fermentedfly/tankia_2013/README.md

# TANKIA 2013
There Are [still] No Kangaroos In Austria

This repository contains hard & software for TANKIA 2013 developed after end of season 2013
