fermentedfly/tankia_2013/layouts/steering_wheel_V3.0.brd

## EAGLE design layouts/steering_wheel_V3.0.brd (2016-11-24, an earlier design)

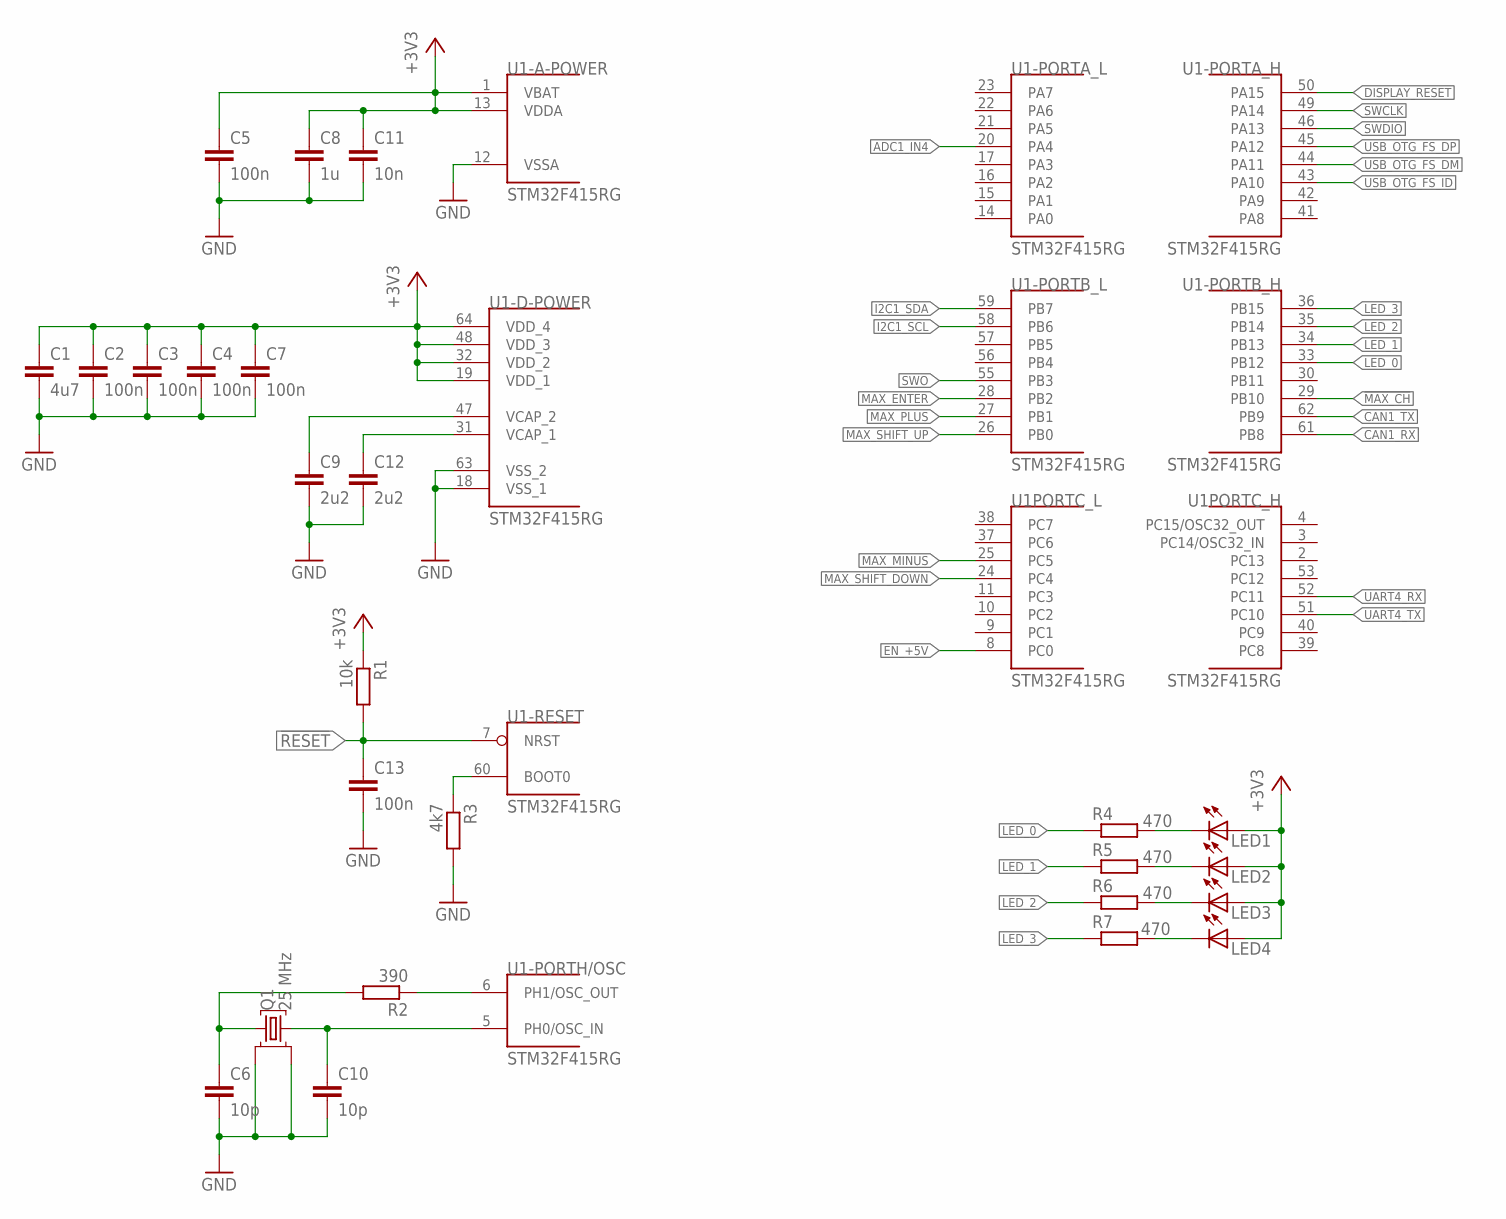
[picture p1: schematic steering_wheel_V3.0.sch, sheet 1]

Parts:
C1: 4u7; C0603
C2, C3, C4, C5, C7, C13: 100n; C0603
C6, C10: 10p; C0603
C8: 1u; C0603
C9, C12: 2u2; C0603
C11: 10n; C0603
LED1, LED2, LED3, LED4: LEDCHIPLED_0603; CHIPLED_0603
Q1: 25 MHz; 3.2X2.5MM-SMD
R1: 10k; R0603
R2: 390; R0603
R3: 4k7; R0603
R4, R5, R6, R7: 470; R0603
U1: STM32F415RG; LQFP64

Connections:
!MAX_CH: U1.29 (PB10); also elsewhere on the board
!RESET: C13.1, R1.2, U1.7 (NRST); also elsewhere on the board
+3V3: C1.1, C2.1, C3.1, C4.1, C5.1, C7.1, C8.1, C11.1, LED1.A, LED2.A, LED3.A, LED4.A, R1.1, U1.1 (VBAT), U1.13 (VDDA), U1.19 (VDD_1), U1.32 (VDD_2), U1.48 (VDD_3), U1.64 (VDD_4); also elsewhere on the board
ADC1_IN4: U1.20 (PA4); also elsewhere on the board
CAN1_RX: U1.61 (PB8); also elsewhere on the board
CAN1_TX: U1.62 (PB9); also elsewhere on the board
DISPLAY_RESET: U1.50 (PA15); also elsewhere on the board
EN_+5V: U1.8 (PC0); also elsewhere on the board
GND: C1.2, C2.2, C3.2, C4.2, C5.2, C6.2, C7.2, C8.2, C9.2, C10.2, C11.2, C12.2, C13.2, Q1.2 (GND1), Q1.4 (GND2), R3.2, U1.12 (VSSA), U1.18 (VSS_1), U1.63 (VSS_2); also elsewhere on the board
I2C1_SCL: U1.58 (PB6); also elsewhere on the board
I2C1_SDA: U1.59 (PB7); also elsewhere on the board
LED_0: R4.1, U1.33 (PB12)
LED_1: R5.1, U1.34 (PB13)
LED_2: R6.1, U1.35 (PB14)
LED_3: R7.1, U1.36 (PB15)
MAX_ENTER: U1.28 (PB2); also elsewhere on the board
MAX_MINUS: U1.25 (PC5); also elsewhere on the board
MAX_PLUS: U1.27 (PB1); also elsewhere on the board
MAX_SHIFT_DOWN: U1.24 (PC4); also elsewhere on the board
MAX_SHIFT_UP: U1.26 (PB0); also elsewhere on the board
unnamed: C9.1, U1.47 (VCAP_2)
unnamed: C12.1, U1.31 (VCAP_1)
unnamed: R2.1, U1.6 (PH1/OSC_OUT)
unnamed: C10.1, Q1.3 (Q2), U1.5 (PH0/OSC_IN)
unnamed: LED4.C, R7.2
unnamed: R3.1, U1.60 (BOOT0)
unnamed: LED2.C, R5.2
unnamed: LED3.C, R6.2
unnamed: C6.1, Q1.1 (Q1), R2.2
unnamed: LED1.C, R4.2
SWCLK: U1.49 (PA14); also elsewhere on the board
SWDIO: U1.46 (PA13); also elsewhere on the board
SWO: U1.55 (PB3); also elsewhere on the board
UART4_RX: U1.52 (PC11); also elsewhere on the board
UART4_TX: U1.51 (PC10); also elsewhere on the board
USB_OTG_FS_DM: U1.44 (PA11); also elsewhere on the board
USB_OTG_FS_DP: U1.45 (PA12); also elsewhere on the board
USB_OTG_FS_ID: U1.43 (PA10); also elsewhere on the board

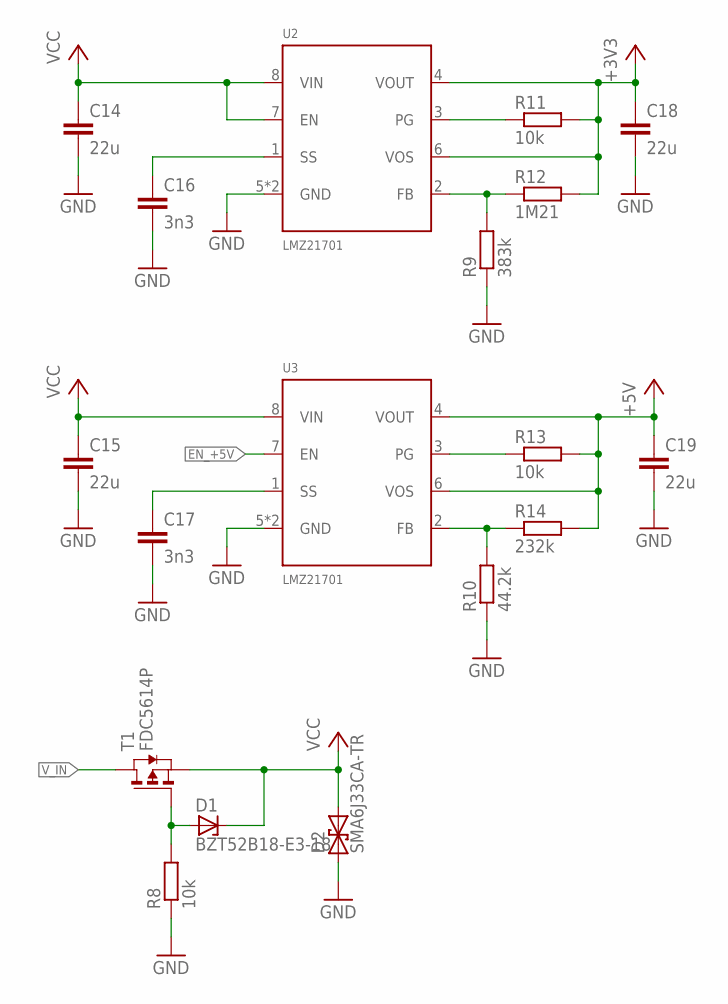
[picture p2: schematic steering_wheel_V3.0.sch, sheet 2]

Parts:
C14, C15, C18, C19: 22u; C1210
C16, C17: 3n3; C0603
D1: BZT52B18-E3-18; SOD123F
D2: SMA6J33CA-TR; DO214AC
R8, R11, R13: 10k; R0603
R9: 383k; R0603
R10: 44.2k; R0603
R12: 1M21; R0603
R14: 232k; R0603
T1: FDC5614P; SSOT6
U2, U3: LMZ21701; SIL0008E

Connections:
+3V3: C18.1, R11.2, R12.2, U2.4 (VOUT), U2.6 (VOS); also elsewhere on the board
+5V: C19.1, R13.2, R14.2, U3.4 (VOUT), U3.6 (VOS); also elsewhere on the board
EN_+5V: U3.7 (EN); also elsewhere on the board
GND: C14.2, C15.2, C16.2, C17.2, C18.2, C19.2, D2.A (1), R8.1, R9.1, R10.1, U2.5 (GND), U2.PAD (GND), U3.5 (GND), U3.PAD (GND); also elsewhere on the board
unnamed: D1.A, R8.2, T1.3 (G)
unnamed: C16.1, U2.1 (SS)
unnamed: C17.1, U3.1 (SS)
unnamed: R13.1, U3.3 (PG)
unnamed: R11.1, U2.3 (PG)
unnamed: R9.2, R12.1, U2.2 (FB)
unnamed: R10.2, R14.1, U3.2 (FB)
VCC: C14.1, C15.1, D1.C, D2.C (2), T1.4 (S), U2.7 (EN), U2.8 (VIN), U3.8 (VIN)
V_IN: T1.1 (D), T1.2 (D), T1.5 (D), T1.6 (D); also elsewhere on the board

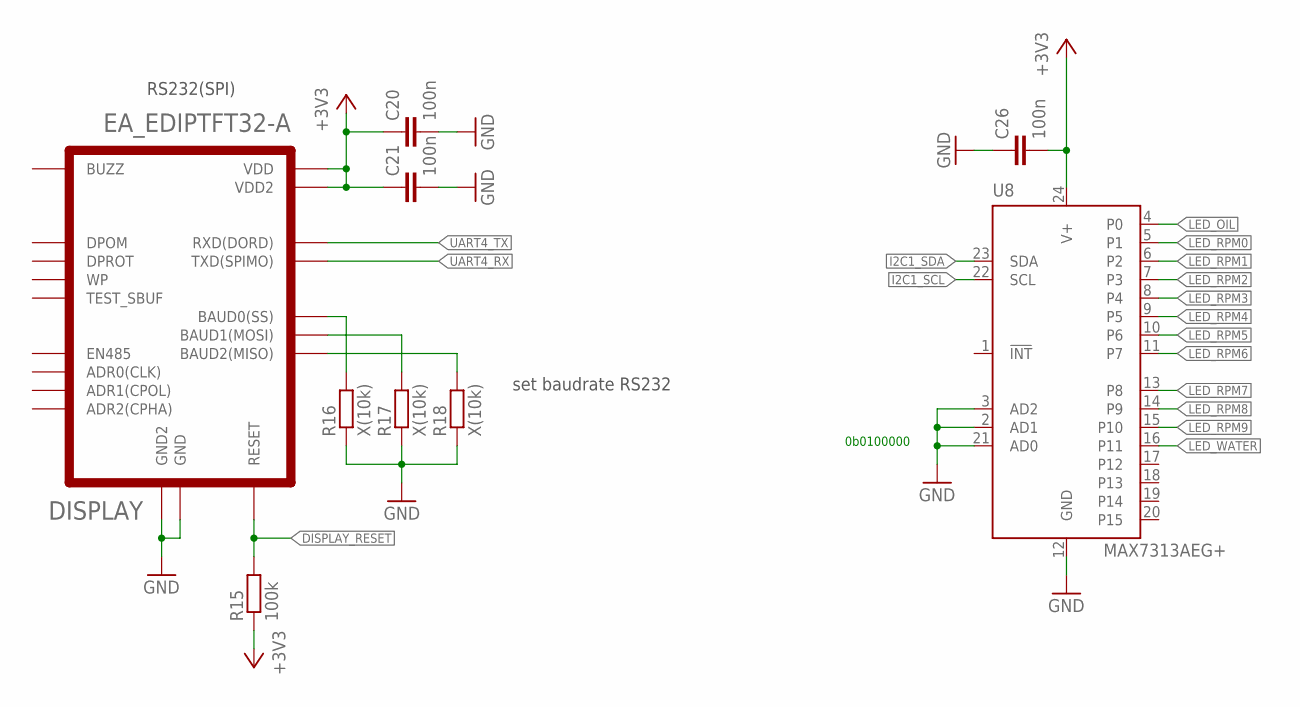
[picture p3: schematic steering_wheel_V3.0.sch, sheet 3]

Parts:
C20, C21, C26: 100n; C0603
DISPLAY: EA_EDIPTFT32-A; EDIPTFT32-A
R15: 100k; R0603
R16, R17, R18: X(10k); R0603
U8: MAX7313AEG+; QSOP-24

Connections:
+3V3: C20.1, C21.1, C26.2, DISPLAY.P$2 (VDD), DISPLAY.P$22 (VDD2), R15.1, U8.24 (V+); also elsewhere on the board
DISPLAY_RESET: DISPLAY.P$5 (RESET), R15.2; also elsewhere on the board
GND: C20.2, C21.2, C26.1, DISPLAY.P$1 (GND), DISPLAY.P$21 (GND2), R16.1, R17.1, R18.1, U8.2 (AD1), U8.3 (AD2), U8.12 (GND), U8.21 (AD0); also elsewhere on the board
I2C1_SCL: U8.22 (SCL); also elsewhere on the board
I2C1_SDA: U8.23 (SDA); also elsewhere on the board
LED_OIL: U8.4 (P0); also elsewhere on the board
LED_RPM0: U8.5 (P1); also elsewhere on the board
LED_RPM1: U8.6 (P2); also elsewhere on the board
LED_RPM2: U8.7 (P3); also elsewhere on the board
LED_RPM3: U8.8 (P4); also elsewhere on the board
LED_RPM4: U8.9 (P5); also elsewhere on the board
LED_RPM5: U8.10 (P6); also elsewhere on the board
LED_RPM6: U8.11 (P7); also elsewhere on the board
LED_RPM7: U8.13 (P8); also elsewhere on the board
LED_RPM8: U8.14 (P9); also elsewhere on the board
LED_RPM9: U8.15 (P10); also elsewhere on the board
LED_WATER: U8.16 (P11); also elsewhere on the board
unnamed: DISPLAY.P$8 (BAUD2(MISO)), R18.2
unnamed: DISPLAY.P$7 (BAUD1(MOSI)), R17.2
unnamed: DISPLAY.P$6 (BAUD0(SS)), R16.2
UART4_RX: DISPLAY.P$11 (TXD(SPIMO)); also elsewhere on the board
UART4_TX: DISPLAY.P$10 (RXD(DORD)); also elsewhere on the board

Notes on the sheet:
set baudrate RS232
0b0100000

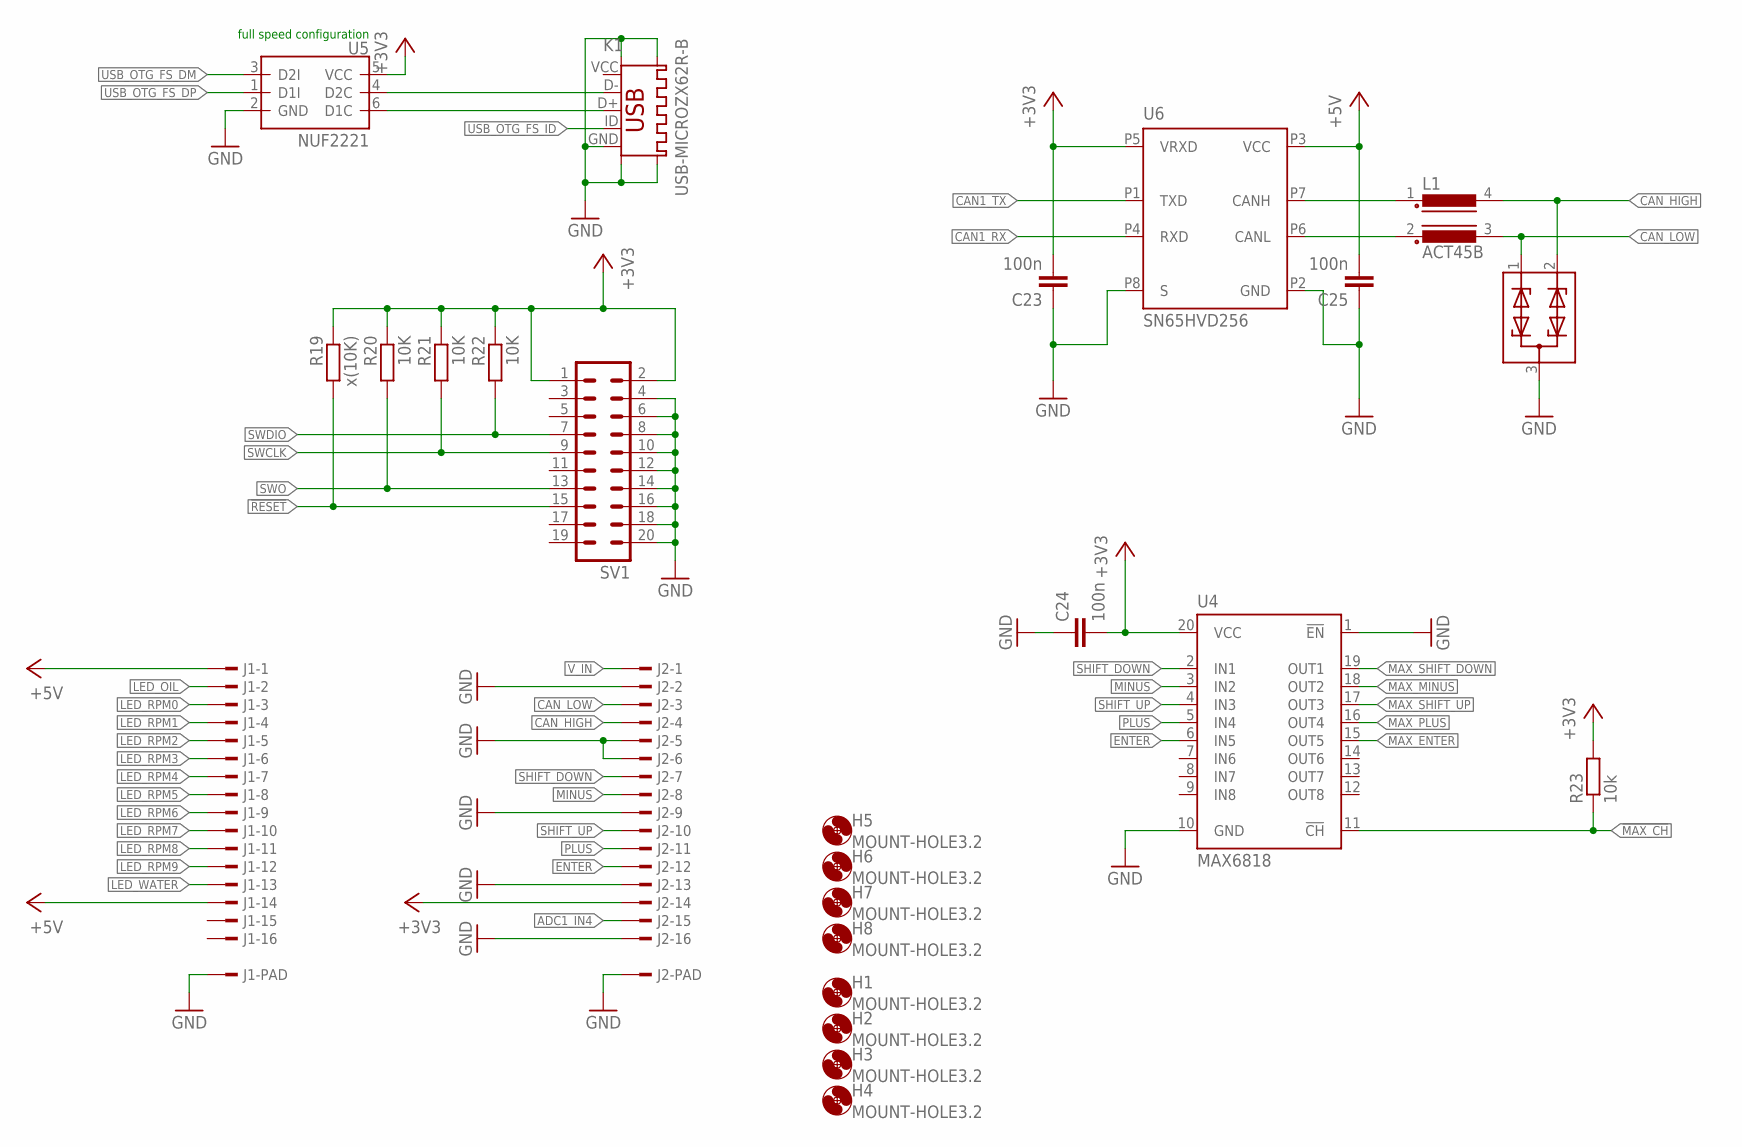
[picture p4: schematic steering_wheel_V3.0.sch, sheet 4]

Parts:
C23, C24, C25: 100n; C0603
D3: PESD1CAN-U; SOT-323
H1, H2, H3, H4, H5, H6, H7, H8: MOUNT-HOLE3.2; 3,2
J1, J2: 1-292227-6
K1: USB-MICROZX62R-B; ZX62R-B
L1: ACT45B
R19: x(10K); R0603
R20, R21, R22: 10K; R0603
R23: 10k; R0603
SV1: ML20
U4: MAX6818; SSOP-20
U5: NUF2221; SOT363
U6: SN65HVD256; SOIC8

Connections:
!MAX_CH: R23.1, U4.11 (!CH); also elsewhere on the board
!RESET: R19.2, SV1.15; also elsewhere on the board
+3V3: C23.2, C24.2, J2.14, R19.1, R20.1, R21.1, R22.1, R23.2, SV1.1, SV1.2, U4.20 (VCC), U5.5 (VCC), U6.P5 (VRXD); also elsewhere on the board
+5V: C25.2, J1.1, J1.14, U6.P3 (VCC); also elsewhere on the board
ADC1_IN4: J2.15; also elsewhere on the board
CAN1_RX: U6.P4 (RXD); also elsewhere on the board
CAN1_TX: U6.P1 (TXD); also elsewhere on the board
CAN_HIGH: D3.2, J2.4, L1.4
CAN_LOW: D3.1, J2.3, L1.3
ENTER: J2.12, U4.6 (IN5)
GND: C23.1, C24.1, C25.1, D3.3, J1.PAD1, J1.PAD2, J2.2, J2.5, J2.6, J2.9, J2.13, J2.16, J2.PAD1, J2.PAD2, K1.GND, K1.P$6 (GND3), K1.P$7 (GND4), K1.P$8 (GND1), K1.P$9 (GND2), SV1.4, SV1.6, SV1.8, SV1.10, SV1.12, SV1.14, SV1.16, SV1.18, SV1.20, U4.1 (!EN), U4.10 (GND), U5.2 (GND), U6.P2 (GND), U6.P8 (S); also elsewhere on the board
LED_OIL: J1.2; also elsewhere on the board
LED_RPM0: J1.3; also elsewhere on the board
LED_RPM1: J1.4; also elsewhere on the board
LED_RPM2: J1.5; also elsewhere on the board
LED_RPM3: J1.6; also elsewhere on the board
LED_RPM4: J1.7; also elsewhere on the board
LED_RPM5: J1.8; also elsewhere on the board
LED_RPM6: J1.9; also elsewhere on the board
LED_RPM7: J1.10; also elsewhere on the board
LED_RPM8: J1.11; also elsewhere on the board
LED_RPM9: J1.12; also elsewhere on the board
LED_WATER: J1.13; also elsewhere on the board
MAX_ENTER: U4.15 (OUT5); also elsewhere on the board
MAX_MINUS: U4.18 (OUT2); also elsewhere on the board
MAX_PLUS: U4.16 (OUT4); also elsewhere on the board
MAX_SHIFT_DOWN: U4.19 (OUT1); also elsewhere on the board
MAX_SHIFT_UP: U4.17 (OUT3); also elsewhere on the board
MINUS: J2.8, U4.3 (IN2)
unnamed: L1.1, U6.P7 (CANH)
unnamed: L1.2, U6.P6 (CANL)
PLUS: J2.11, U4.5 (IN4)
SHIFT_DOWN: J2.7, U4.2 (IN1)
SHIFT_UP: J2.10, U4.4 (IN3)
SWCLK: R21.2, SV1.9; also elsewhere on the board
SWDIO: R22.2, SV1.7; also elsewhere on the board
SWO: R20.2, SV1.13; also elsewhere on the board
USB_DM: K1.D-, U5.4 (D2C)
USB_DP: K1.D+, U5.6 (D1C)
USB_OTG_FS_DM: U5.3 (D2I); also elsewhere on the board
USB_OTG_FS_DP: U5.1 (D1I); also elsewhere on the board
USB_OTG_FS_ID: K1.ID; also elsewhere on the board
V_IN: J2.1; also elsewhere on the board

Notes on the sheet:
full speed configuration

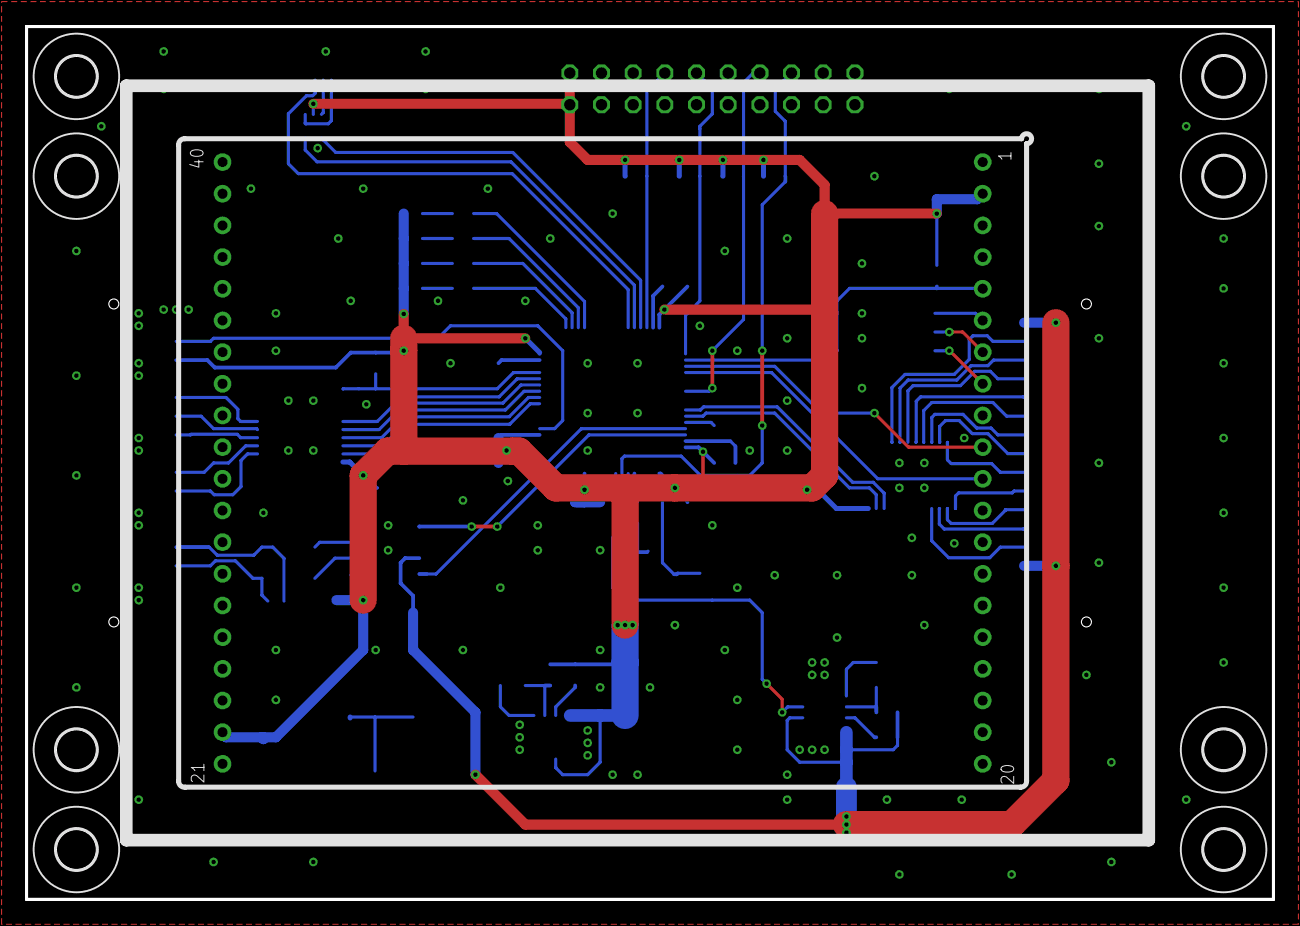
[picture p5: board steering_wheel_V3.0.brd from above]

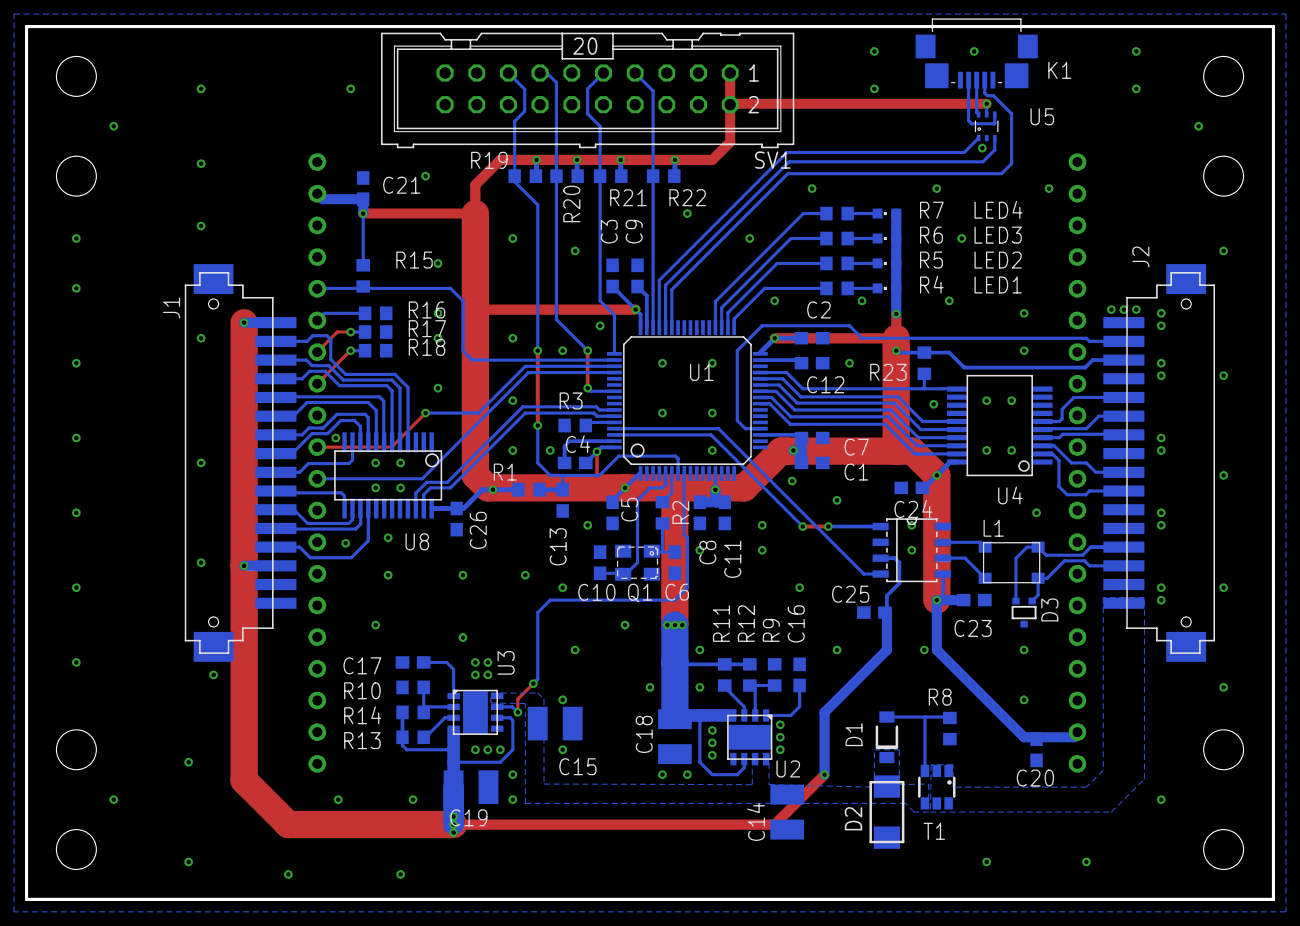
[picture p6: board steering_wheel_V3.0.brd from below]

Board: 2 copper layers, 100.0 x 70.0 mm, 78 parts (69 on the bottom side), 74 nets.
