fermentedfly/tankia_2013/layouts/led_mask.brd

## EAGLE design layouts/led_mask.brd (2016-11-24)

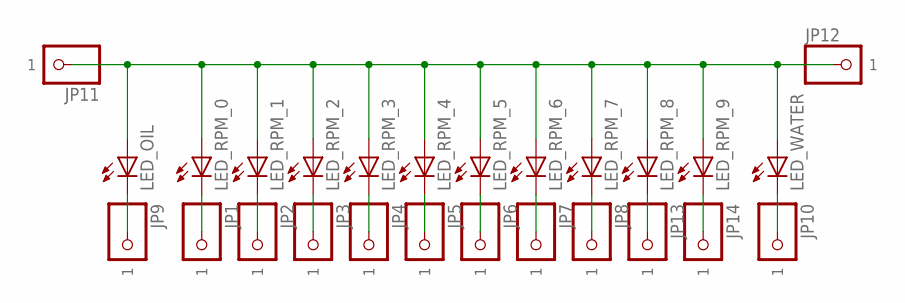
[picture p7: schematic led_mask.sch]

Parts:
JP1, JP2, JP3, JP4, JP5, JP6, JP7, JP8, JP9, JP10, JP11, JP12, JP13, JP14: PINHD-1X11.5X2.5MM_SMD; 1XSMD1.5X2.5MM
LED_OIL: LED3MM
LED_RPM_0, LED_RPM_1, LED_RPM_2, LED_RPM_3, LED_RPM_4, LED_RPM_5, LED_RPM_6, LED_RPM_7, LED_RPM_8, LED_RPM_9: LED3MM
LED_WATER: LED3MM

Connections:
unnamed: JP11.P$1, JP12.P$1, LED_OIL.A, LED_RPM_0.A, LED_RPM_1.A, LED_RPM_2.A, LED_RPM_3.A, LED_RPM_4.A, LED_RPM_5.A, LED_RPM_6.A, LED_RPM_7.A, LED_RPM_8.A, LED_RPM_9.A, LED_WATER.A
unnamed: JP3.P$1, LED_RPM_2.K (C)
unnamed: JP1.P$1, LED_RPM_0.K (C)
unnamed: JP2.P$1, LED_RPM_1.K (C)
unnamed: JP4.P$1, LED_RPM_3.K (C)
unnamed: JP5.P$1, LED_RPM_4.K (C)
unnamed: JP6.P$1, LED_RPM_5.K (C)
unnamed: JP7.P$1, LED_RPM_6.K (C)
unnamed: JP8.P$1, LED_RPM_7.K (C)
unnamed: JP9.P$1, LED_OIL.K (C)
unnamed: JP10.P$1, LED_WATER.K (C)
unnamed: JP13.P$1, LED_RPM_8.K (C)
unnamed: JP14.P$1, LED_RPM_9.K (C)

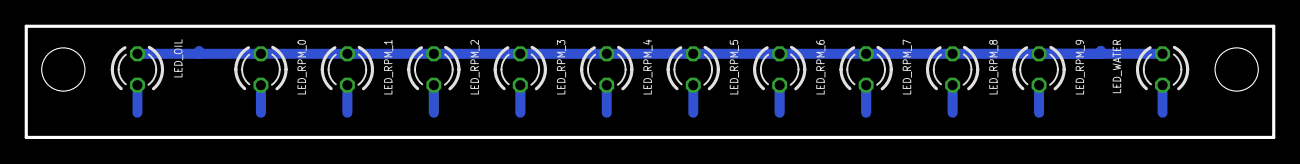
[picture p8: board led_mask.brd from above]

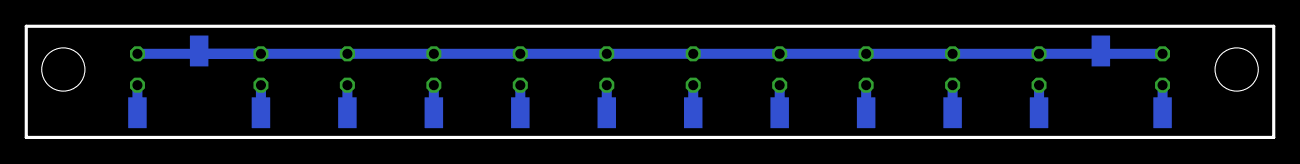
[picture p9: board led_mask.brd from below]

Board: 2 copper layers, 101.0 x 9.0 mm, 26 parts (14 on the bottom side), 13 nets.
