fermentedfly/tankia_2013/layouts/steering_wheel_V2.brd

## EAGLE design layouts/steering_wheel_V2.brd (2016-11-24, an earlier design)

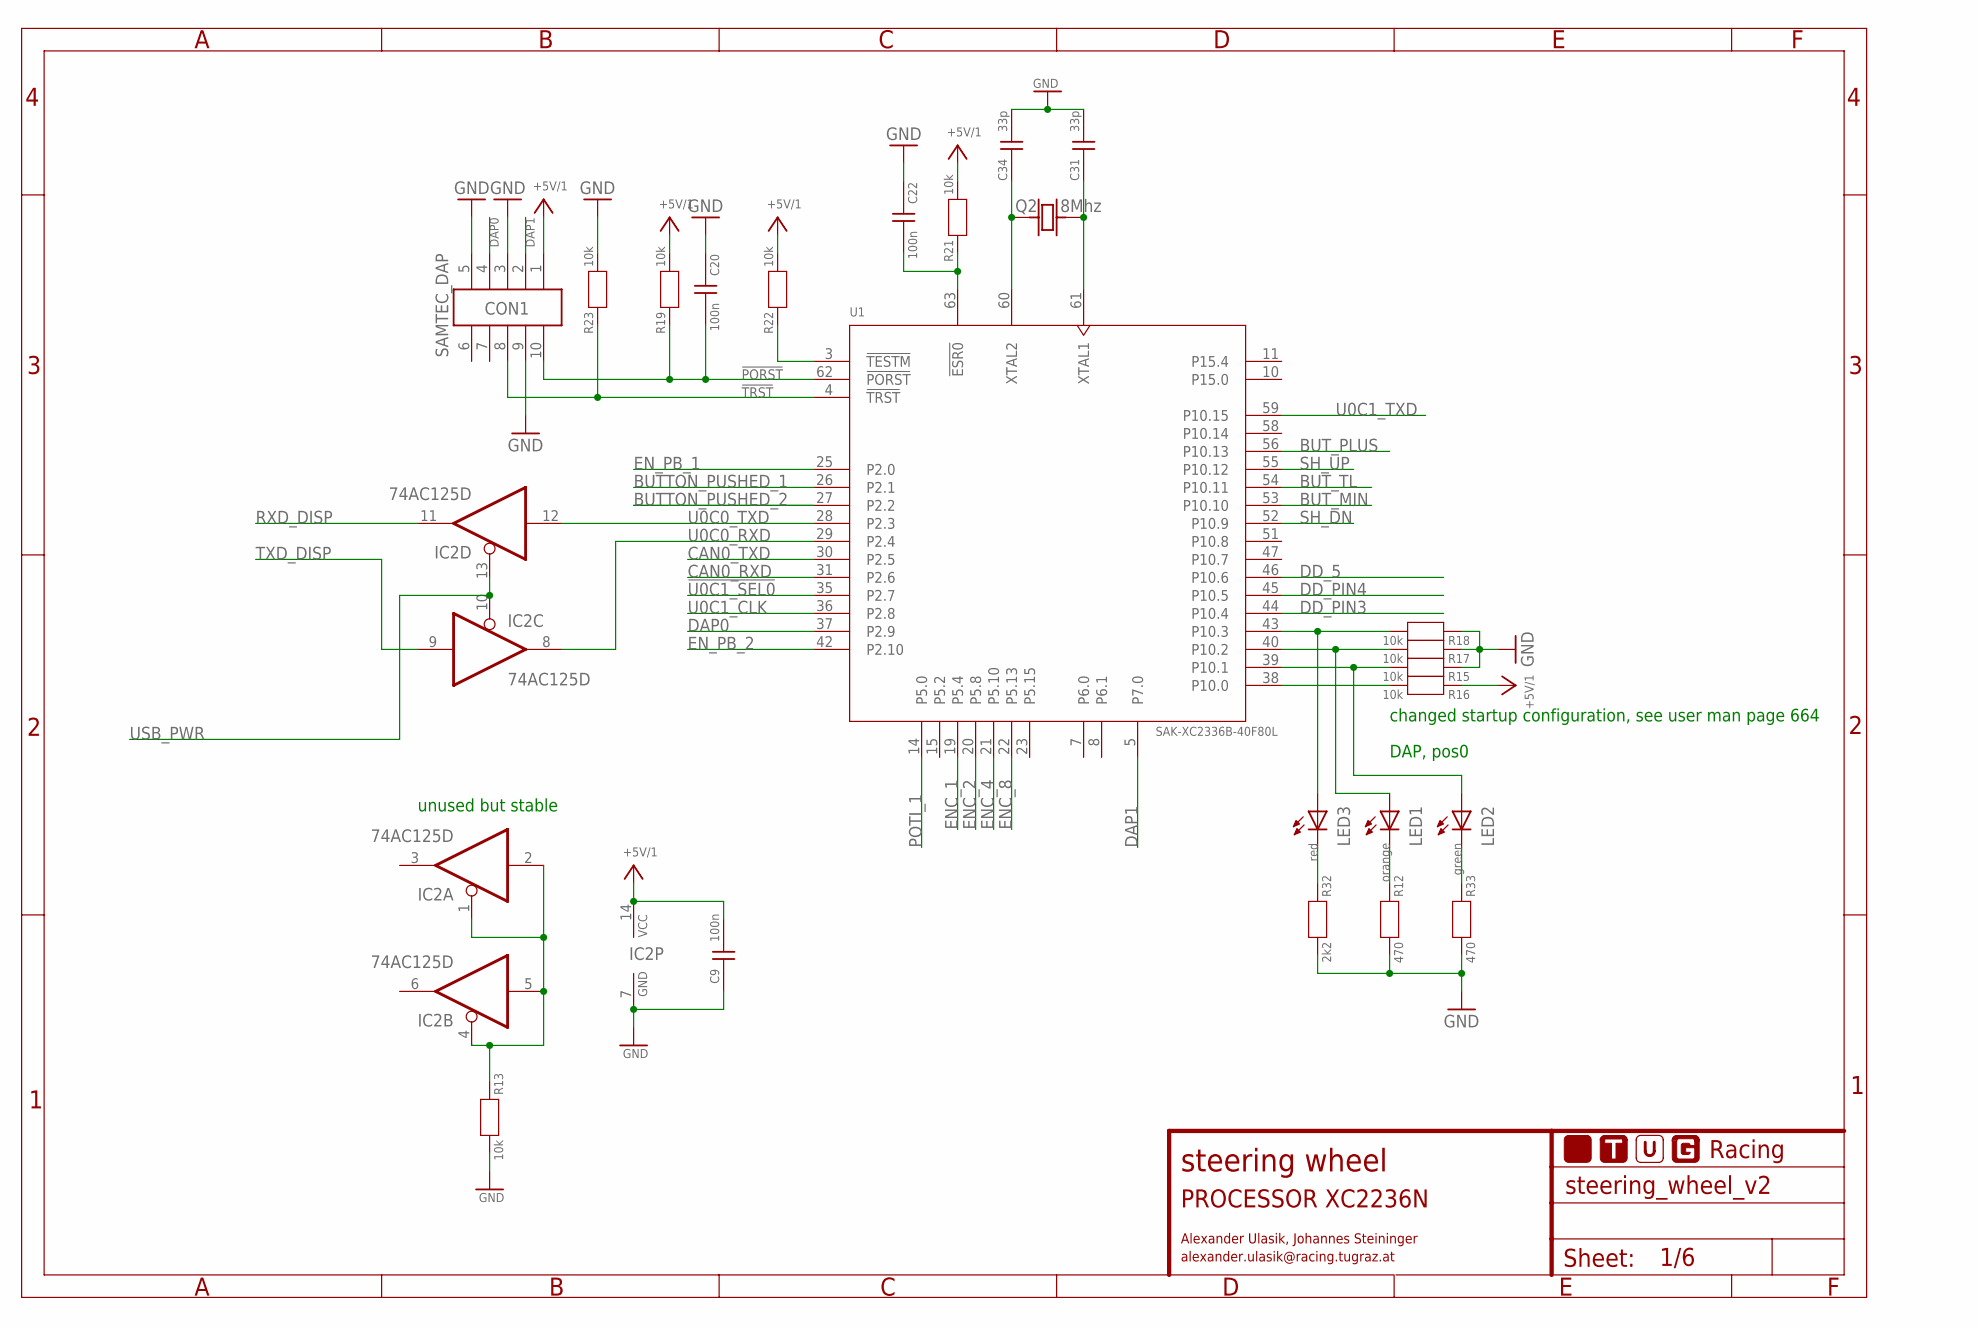
[picture p10: schematic steering_wheel_V2.sch, sheet 1]

Parts:
C9: 100n; 1608M_0603
C20, C22: 100n; 2012M_0805
C31, C34: 33p; 1608M_0603
CON1: SAMTEC_DAP; FTSH-105-01-XXX-DV-K
FRAME1: A4L-LOC-RACING-NOLOGO; NOLOGO
IC2: 74AC125D; SO14
LED1, LED2, LED3: LEDCHIPLED_0805; CHIPLED_0805
Q2: 8Mhz; ABMM2
R12, R33: 470; 2012M_0805
R13, R15, R16, R17, R18, R19, R21, R22, R23: 10k; 2012M_0805
R32: 2k2; 2012M_0805
U1: SAK-XC2336B-40F80L; PG-LQFP-64-6

Connections:
!PORST: C20.2, CON1.10, R19.1, U1.62 (!PORST); also elsewhere on the board
!TRST: CON1.8, R23.1, U1.4 (!TRST); also elsewhere on the board
!U0C1_SEL0: U1.35 (P2.7); also elsewhere on the board
+5V/1#: C9.2, CON1.1, IC2.14 (VCC), R16.1, R19.2, R21.2, R22.2; also elsewhere on the board
BUTTON_PUSHED_1: U1.26 (P2.1); also elsewhere on the board
BUTTON_PUSHED_2: U1.27 (P2.2); also elsewhere on the board
BUT_MIN: U1.53 (P10.10); also elsewhere on the board
BUT_PLUS: U1.56 (P10.13); also elsewhere on the board
BUT_TL: U1.54 (P10.11); also elsewhere on the board
CAN0_RXD: U1.31 (P2.6); also elsewhere on the board
CAN0_TXD: U1.30 (P2.5); also elsewhere on the board
DAP0: CON1.4, U1.37 (P2.9); also elsewhere on the board
DAP1: CON1.2, U1.5 (P7.0); also elsewhere on the board
DD_5: U1.46 (P10.6); also elsewhere on the board
DD_PIN3: U1.44 (P10.4); also elsewhere on the board
DD_PIN4: U1.45 (P10.5); also elsewhere on the board
ENC_1: U1.19 (P5.4); also elsewhere on the board
ENC_2: U1.20 (P5.8); also elsewhere on the board
ENC_4: U1.21 (P5.10); also elsewhere on the board
ENC_8: U1.22 (P5.13); also elsewhere on the board
EN_PB_1: U1.25 (P2.0); also elsewhere on the board
EN_PB_2: U1.42 (P2.10); also elsewhere on the board
GND: C9.1, C20.1, C22.1, C31.2, C34.2, CON1.3, CON1.5, CON1.9, IC2.7 (GND), R12.2, R13.2, R15.1, R17.1, R18.1, R23.2, R32.2, R33.2; also elsewhere on the board
unnamed: C31.1, Q2.1, U1.61 (XTAL1)
unnamed: C34.1, Q2.3 (2), U1.60 (XTAL2)
unnamed: R22.1, U1.3 (!TESTM)
unnamed: C22.2, R21.1, U1.63 (!ESR0)
unnamed: LED1.C, R12.1
unnamed: LED2.C, R33.1
unnamed: LED3.A, R18.2, U1.43 (P10.3)
unnamed: IC2.1 (OE), IC2.2 (I), IC2.4 (OE), IC2.5 (I), R13.1
unnamed: LED3.C, R32.1
POTI_1: U1.14 (P5.0); also elsewhere on the board
RXD_DISP: IC2.11 (O); also elsewhere on the board
SH_DN: U1.52 (P10.9); also elsewhere on the board
SH_UP: U1.55 (P10.12); also elsewhere on the board
STATUS_0: R16.2, U1.38 (P10.0)
STATUS_1: LED2.A, R15.2, U1.39 (P10.1)
STATUS_2: LED1.A, R17.2, U1.40 (P10.2)
TXD_DISP: IC2.9 (I); also elsewhere on the board
U0C0_RXD: IC2.8 (O), U1.29 (P2.4)
U0C0_TXD: IC2.12 (I), U1.28 (P2.3)
U0C1_CLK: U1.36 (P2.8); also elsewhere on the board
U0C1_TXD: U1.59 (P10.15); also elsewhere on the board
USB_PWR: IC2.10 (OE), IC2.13 (OE); also elsewhere on the board

Notes on the sheet:
changed startup configuration, see user man page 664
DAP, pos0
unused but stable

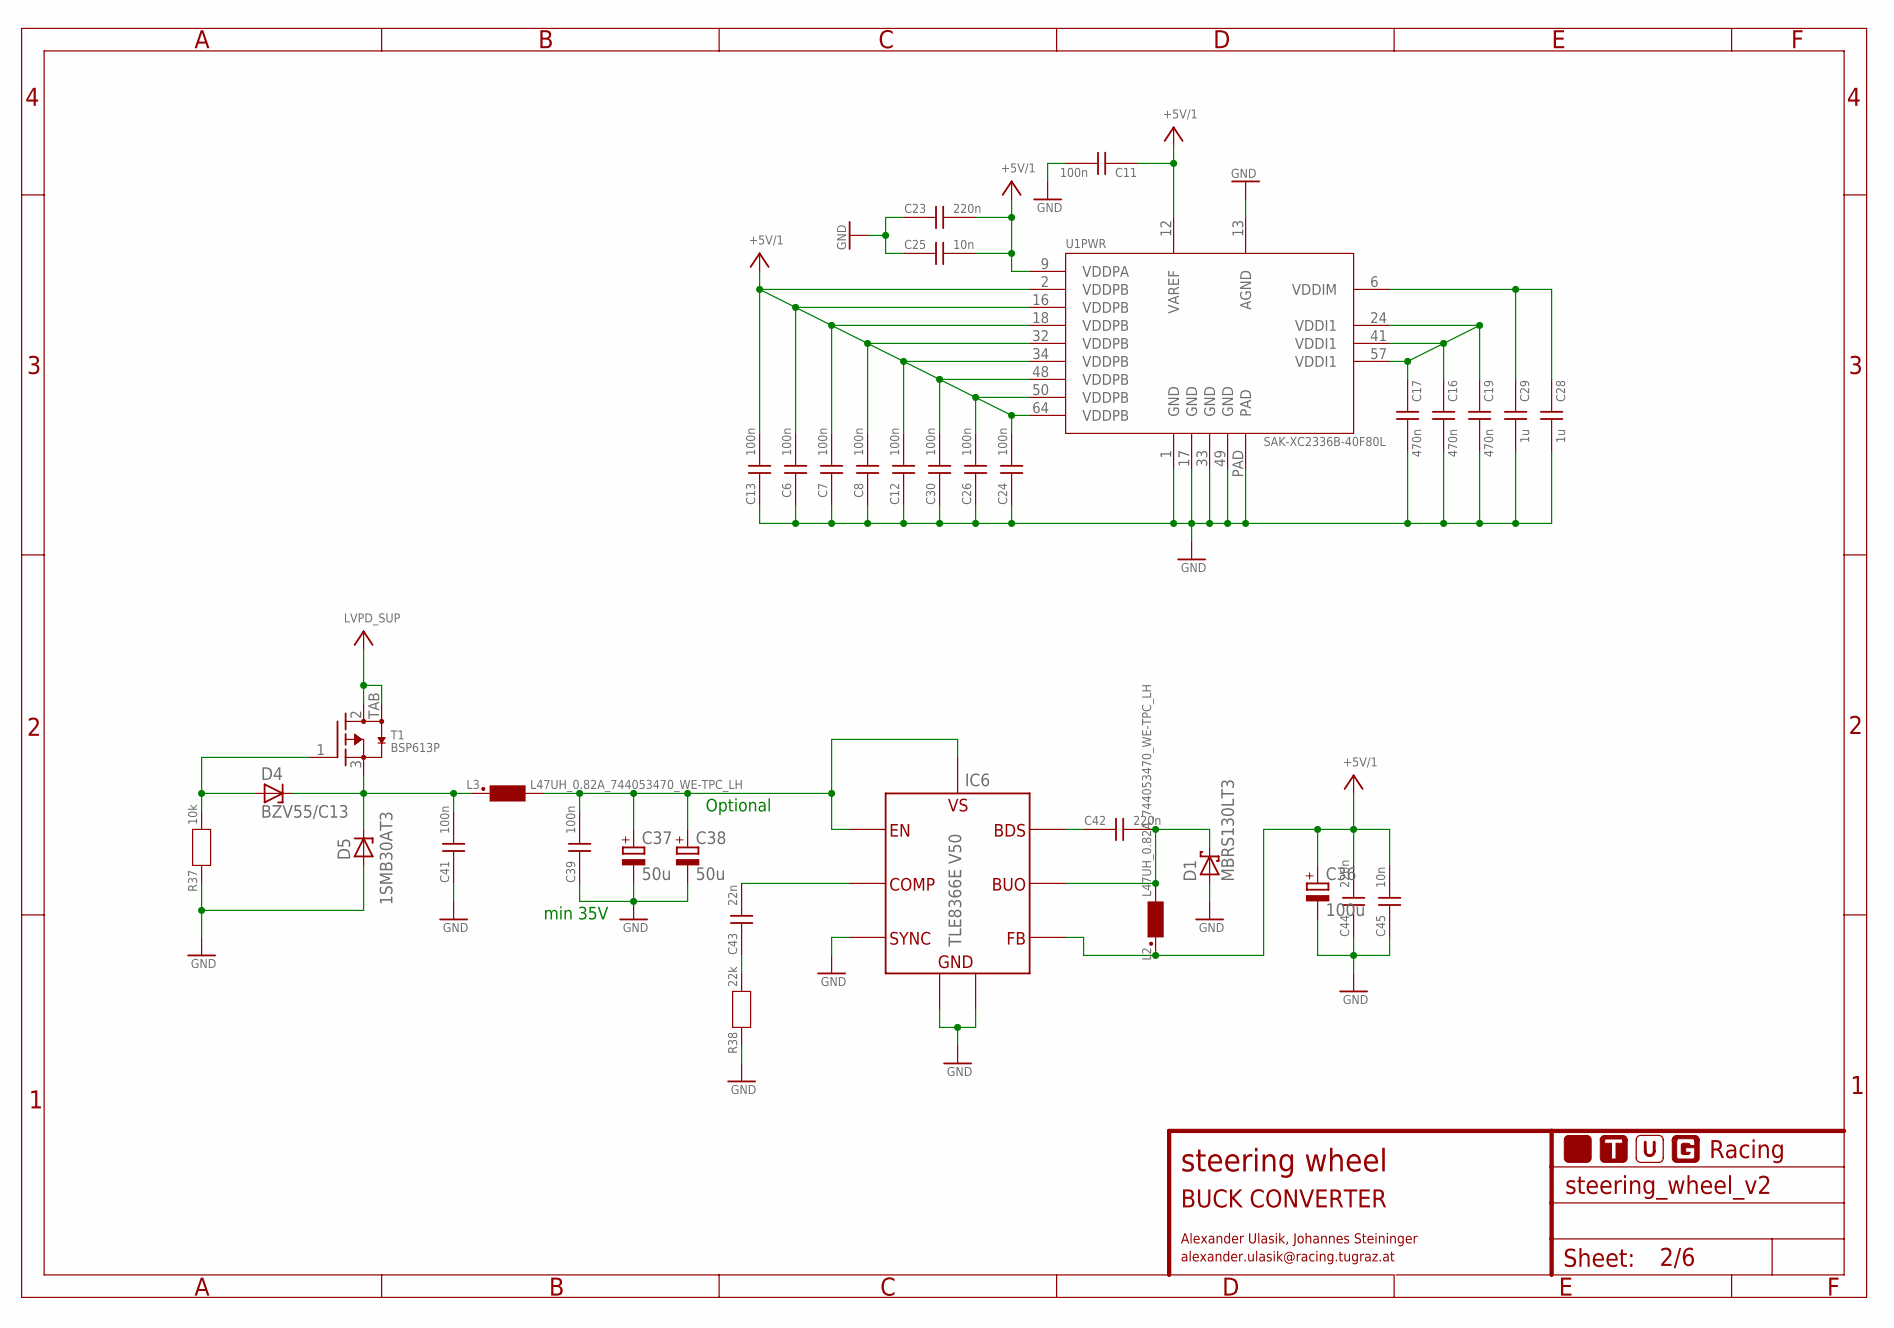
[picture p11: schematic steering_wheel_V2.sch, sheet 2]

Parts:
C6, C7, C8, C11, C12, C13, C24, C26, C30, C39, C41: 100n; 2012M_0805
C16, C17, C19: 470n; 2012M_0805
C23, C42, C44: 220n; 2012M_0805
C25, C45: 10n; 2012M_0805
C28, C29: 1u; 2012M_0805
C36: 100u; E5-10,5
C37, C38: 50u; E5-10,5
C43: 22n; 2012M_0805
D1: MBRS130LT3; SMB
D4: BZV55/C13; SOD80C
D5: 1SMB30AT3; SMB
FRAME4: A4L-LOC-RACING-BRD-TPLACE; LOGO_RACING_BRD_TPLACE
IC6: TLE8366E V50; SOIC08-II
L2, L3: L47UH_0.82A_744053470_WE-TPC_LH; WE-TPC_LH
R37: 10k; 2012M_0805
R38: 22k; 2012M_0805
T1: BSP613P; SOT223-3
U1: SAK-XC2336B-40F80L; PG-LQFP-64-6

Connections:
+5V/1#: C6.2, C7.2, C8.2, C11.1, C12.2, C13.2, C23.2, C24.2, C25.2, C26.2, C30.2, C36.+, C44.2, C45.2, IC6.4 (FB), L2.1, U1.2 (VDDPB), U1.9 (VDDPA), U1.12 (VAREF), U1.16 (VDDPB), U1.18 (VDDPB), U1.32 (VDDPB), U1.34 (VDDPB), U1.48 (VDDPB), U1.50 (VDDPB), U1.64 (VDDPB); also elsewhere on the board
GND: C6.1, C7.1, C8.1, C11.2, C12.1, C13.1, C16.2, C17.2, C19.2, C23.1, C24.1, C25.1, C26.1, C28.2, C29.2, C30.1, C36.-, C37.-, C38.-, C39.1, C41.1, C44.1, C45.1, D1.A, D5.A, IC6.1 (SYNC), IC6.2 (GND1), IC6.HS (GND2), R37.1, R38.1, U1.1 (GND), U1.13 (AGND), U1.17 (GND), U1.33 (GND), U1.49 (GND), U1.PAD; also elsewhere on the board
LVPD_SUP: T1.2 (D), T1.TAB (D); also elsewhere on the board
unnamed: C16.1, C17.1, C19.1, U1.24 (VDDI1), U1.41 (VDDI1), U1.57 (VDDI1)
unnamed: C28.1, C29.1, U1.6 (VDDIM)
unnamed: C37.+, C38.+, C39.2, IC6.7 (EN), IC6.8 (VS), L3.2
unnamed: C43.1, R38.2
unnamed: D4.A, R37.2, T1.1 (G)
unnamed: C43.2, IC6.3 (COMP)
unnamed: C42.2, D1.C, IC6.6 (BUO), L2.2
unnamed: C42.1, IC6.5 (BDS)
SUP6.1: C41.2, D4.C, D5.C, L3.1, T1.3 (S)

Notes on the sheet:
min 35V
Optional
