fermentedfly/tankia_2013/layouts/steering_wheel_V2.brd

## EAGLE design layouts/steering_wheel_V2.brd (continued)

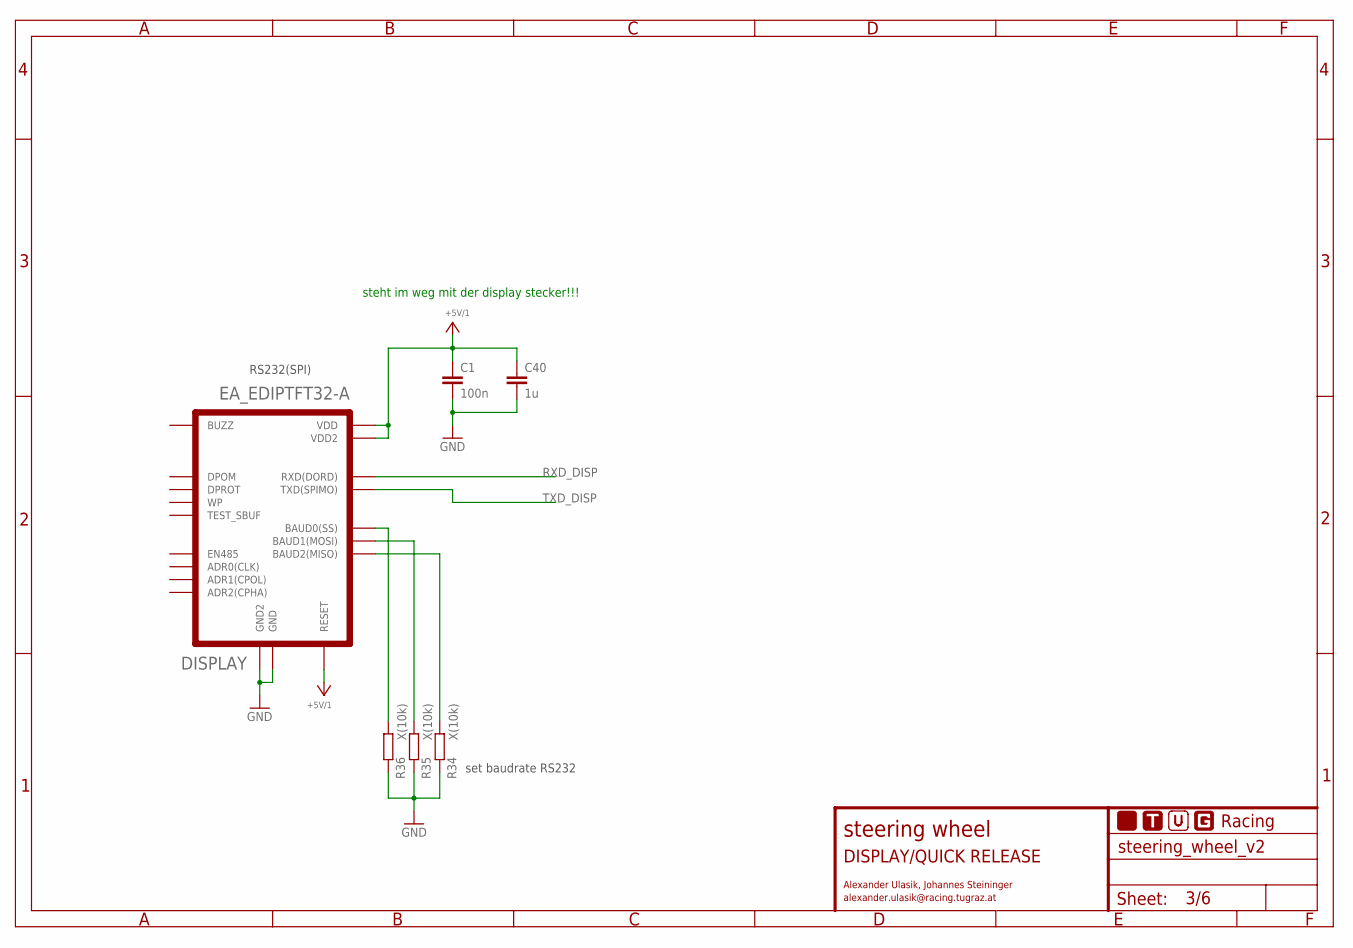
[picture p12: schematic steering_wheel_V2.sch, sheet 3]

Parts:
C1: 100n; C0805
C40: 1u; C0805
DISPLAY: EA_EDIPTFT32-A; EDIPTFT32-A
FRAME3: A4L-LOC-RACING-NOLOGO; NOLOGO
R34, R35, R36: X(10k); R0805

Connections:
+5V/1#: C1.1, C40.1, DISPLAY.P$2 (VDD), DISPLAY.P$5 (RESET), DISPLAY.P$22 (VDD2); also elsewhere on the board
GND: C1.2, C40.2, DISPLAY.P$1 (GND), DISPLAY.P$21 (GND2), R34.1, R35.1, R36.1; also elsewhere on the board
unnamed: DISPLAY.P$8 (BAUD2(MISO)), R34.2
unnamed: DISPLAY.P$7 (BAUD1(MOSI)), R35.2
unnamed: DISPLAY.P$6 (BAUD0(SS)), R36.2
RXD_DISP: DISPLAY.P$10 (RXD(DORD)); also elsewhere on the board
TXD_DISP: DISPLAY.P$11 (TXD(SPIMO)); also elsewhere on the board

Notes on the sheet:
set baudrate RS232
steht im weg mit der display stecker!!!

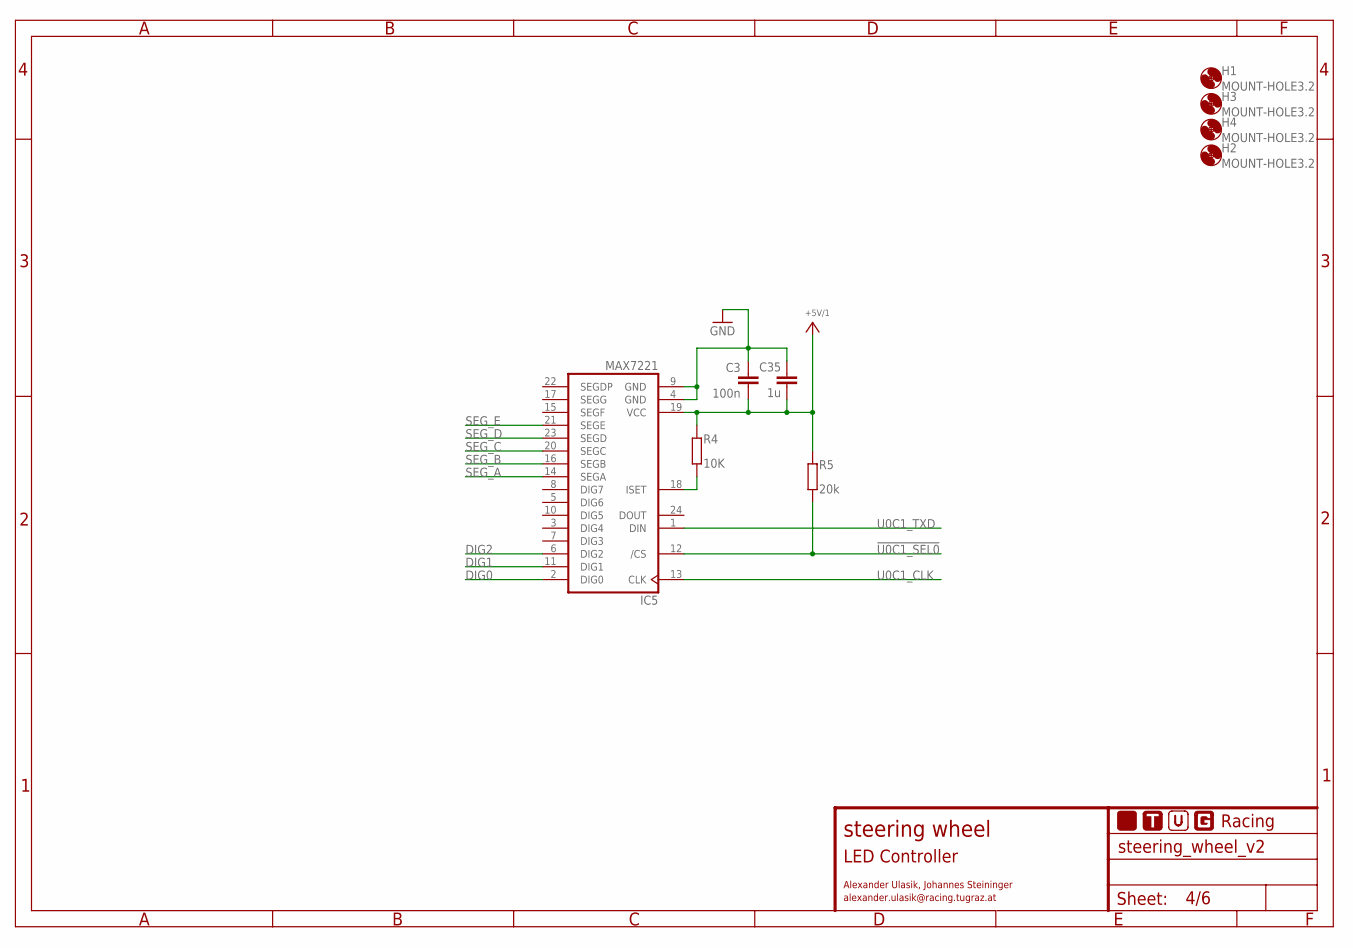
[picture p13: schematic steering_wheel_V2.sch, sheet 4]

Parts:
C3: 100n; C0805
C35: 1u; C0805
FRAME5: A4L-LOC-RACING-NOLOGO; NOLOGO
H1, H2, H3, H4: MOUNT-HOLE3.2; 3,2
IC5: MAX7221; SO_W24
R4: 10K; M0805
R5: 20k; M0805

Connections:
!U0C1_SEL0: IC5.12 (/CS), R5.1; also elsewhere on the board
+5V/1#: C3.1, C35.1, IC5.19 (VCC), R4.1, R5.2; also elsewhere on the board
DIG0: IC5.2 (DIG0); also elsewhere on the board
DIG1: IC5.11 (DIG1); also elsewhere on the board
DIG2: IC5.6 (DIG2); also elsewhere on the board
GND: C3.2, C35.2, IC5.4 (GND), IC5.9 (GND); also elsewhere on the board
unnamed: IC5.18 (ISET), R4.2
SEG_A: IC5.14 (SEGA); also elsewhere on the board
SEG_B: IC5.16 (SEGB); also elsewhere on the board
SEG_C: IC5.20 (SEGC); also elsewhere on the board
SEG_D: IC5.23 (SEGD); also elsewhere on the board
SEG_E: IC5.21 (SEGE); also elsewhere on the board
U0C1_CLK: IC5.13 (CLK); also elsewhere on the board
U0C1_TXD: IC5.1 (DIN); also elsewhere on the board

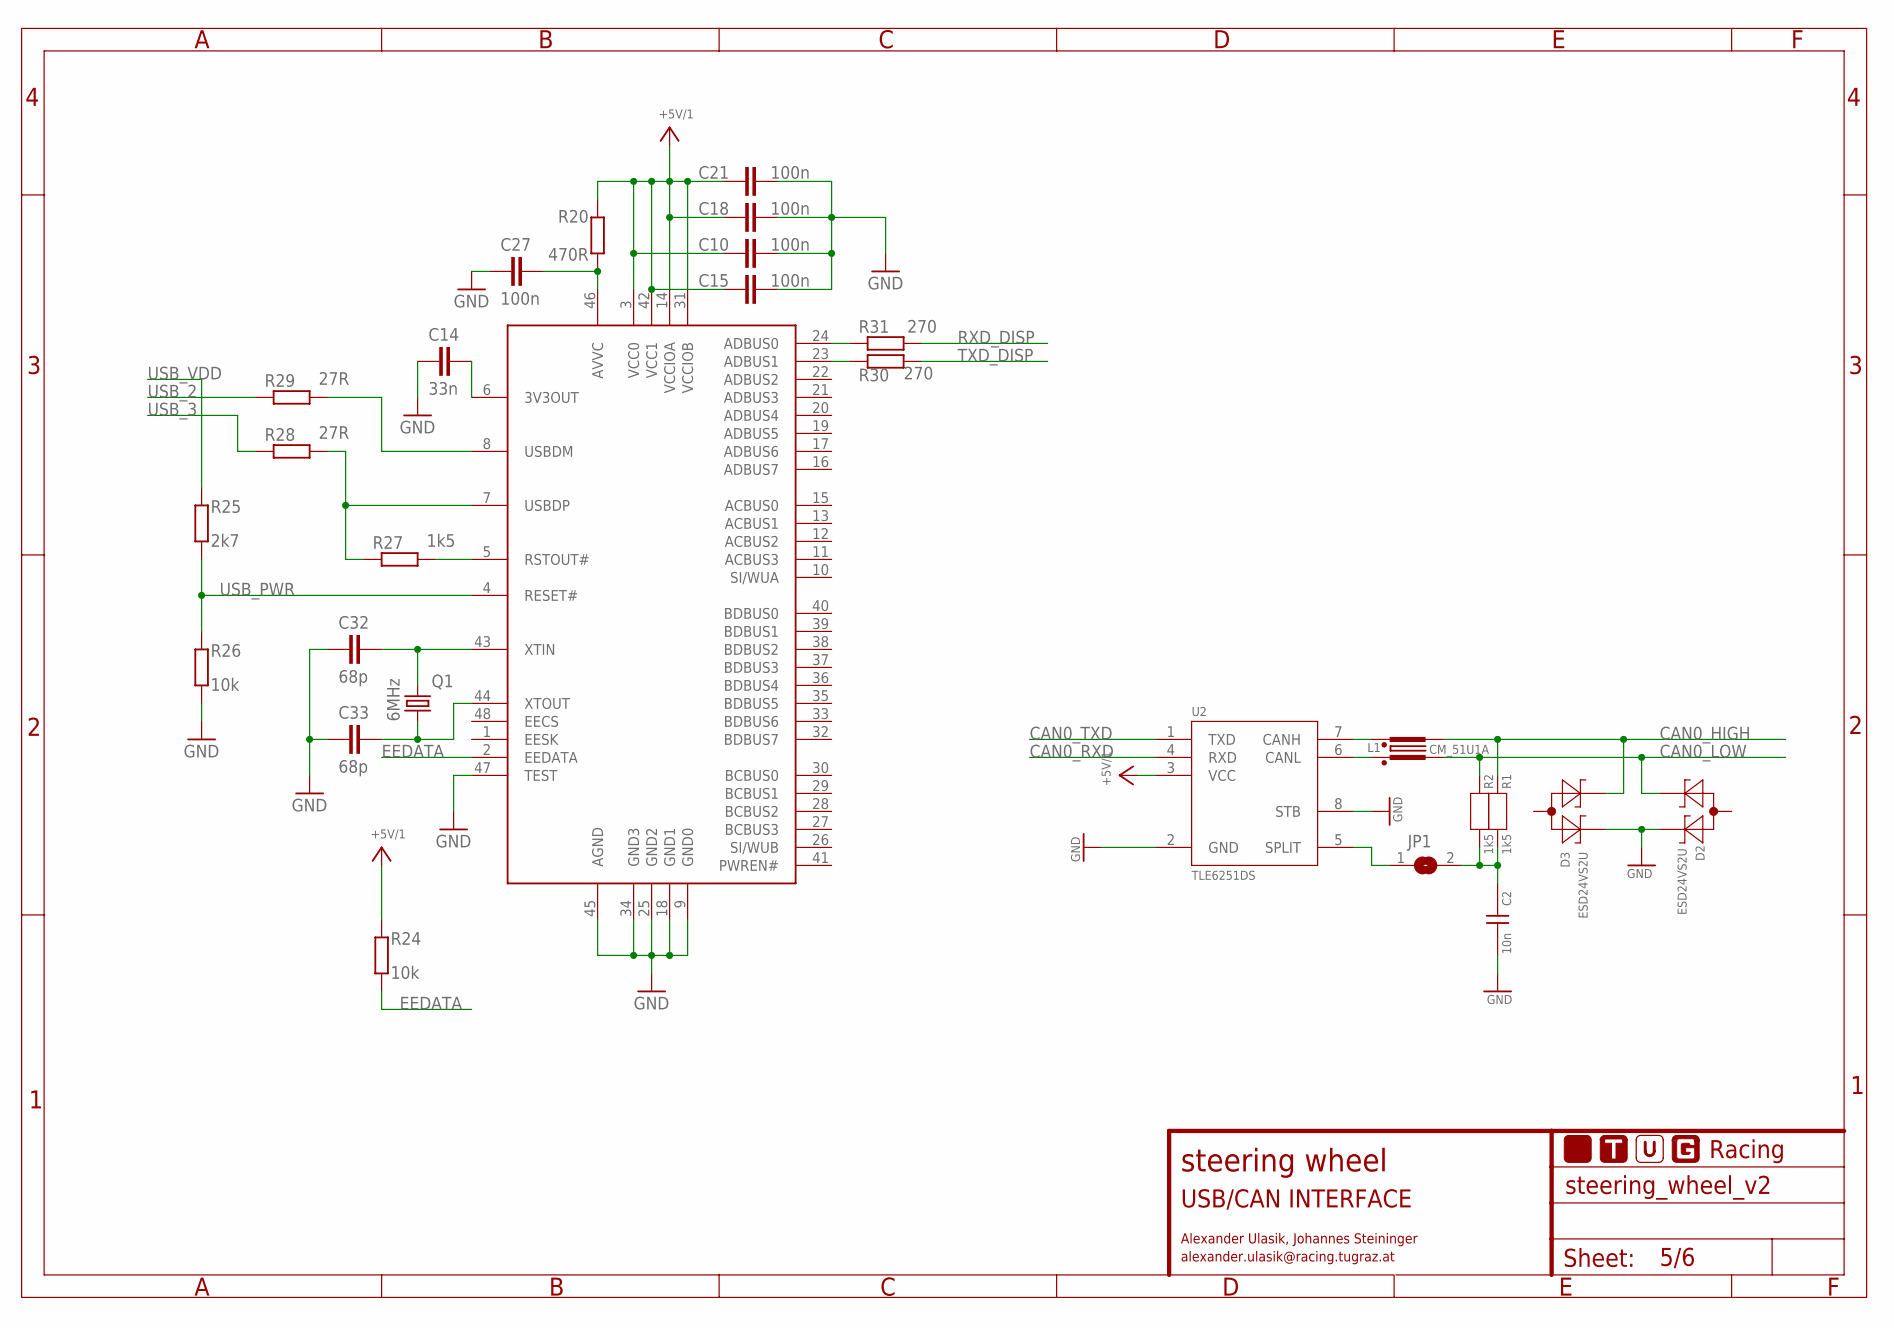
[picture p14: schematic steering_wheel_V2.sch, sheet 5]

Parts:
C2: 10n; 2012M_0805
C10, C15, C18, C21, C27: 100n; C0805
C14: 33n; C0805
C32, C33: 68p; C0805
D2, D3: ESD24VS2U; SOT23-3
FRAME6: A4L-LOC-RACING-BRD-TPLACE; LOGO_RACING_BRD_TPLACE
IC1: FT2232; LQFP48
JP1: SJ
L1: CM_51U1A; WE-SL2
Q1: 6MHz; HC49U70
R1, R2: 1k5; 2012M_0805
R20: 470R; R0805
R24, R26: 10k; R0805
R25: 2k7; R0805
R27: 1k5; R0805
R28, R29: 27R; R0805
R30, R31: 270; R0805
U2: TLE6251DS; SO8

Connections:
+5V/1#: C10.1, C15.1, C18.1, C21.1, IC1.3 (VCC0), IC1.14 (VCCIOA), IC1.31 (VCCIOB), IC1.42 (VCC1), R20.2, R24.2, U2.3 (VCC); also elsewhere on the board
CAN0_HIGH: D3.1 (C1), L1.3, R1.1; also elsewhere on the board
CAN0_LOW: D2.2 (C2), L1.2, R2.1; also elsewhere on the board
CAN0_RXD: U2.4 (RXD); also elsewhere on the board
CAN0_TXD: U2.1 (TXD); also elsewhere on the board
EEDATA: IC1.2 (EEDATA), R24.1
GND: C2.2, C10.2, C14.1, C15.2, C18.2, C21.2, C27.1, C32.1, C33.1, D2.1 (C1), D3.2 (C2), IC1.9 (GND0), IC1.18 (GND1), IC1.25 (GND2), IC1.34 (GND3), IC1.45 (AGND), IC1.47 (TEST), R26.1, U2.2 (GND), U2.8 (STB); also elsewhere on the board
unnamed: C14.2, IC1.6 (3V3OUT)
unnamed: IC1.8 (USBDM), R29.2
unnamed: IC1.7 (USBDP), R27.1, R28.2
unnamed: IC1.5 (RSTOUT#), R27.2
unnamed: C27.2, IC1.46 (AVVC), R20.1
unnamed: L1.4, U2.7 (CANH)
unnamed: L1.1, U2.6 (CANL)
unnamed: IC1.24 (ADBUS0), R31.1
unnamed: IC1.23 (ADBUS1), R30.1
unnamed: C32.2, IC1.43 (XTIN), Q1.2
unnamed: C33.2, IC1.44 (XTOUT), Q1.1
unnamed: JP1.1, U2.5 (SPLIT)
unnamed: C2.1, JP1.2, R1.2, R2.2
RXD_DISP: R31.2; also elsewhere on the board
TXD_DISP: R30.2; also elsewhere on the board
USB_2: R29.1; also elsewhere on the board
USB_3: R28.1; also elsewhere on the board
USB_PWR: IC1.4 (RESET#), R25.1, R26.2; also elsewhere on the board
USB_VDD: R25.2; also elsewhere on the board

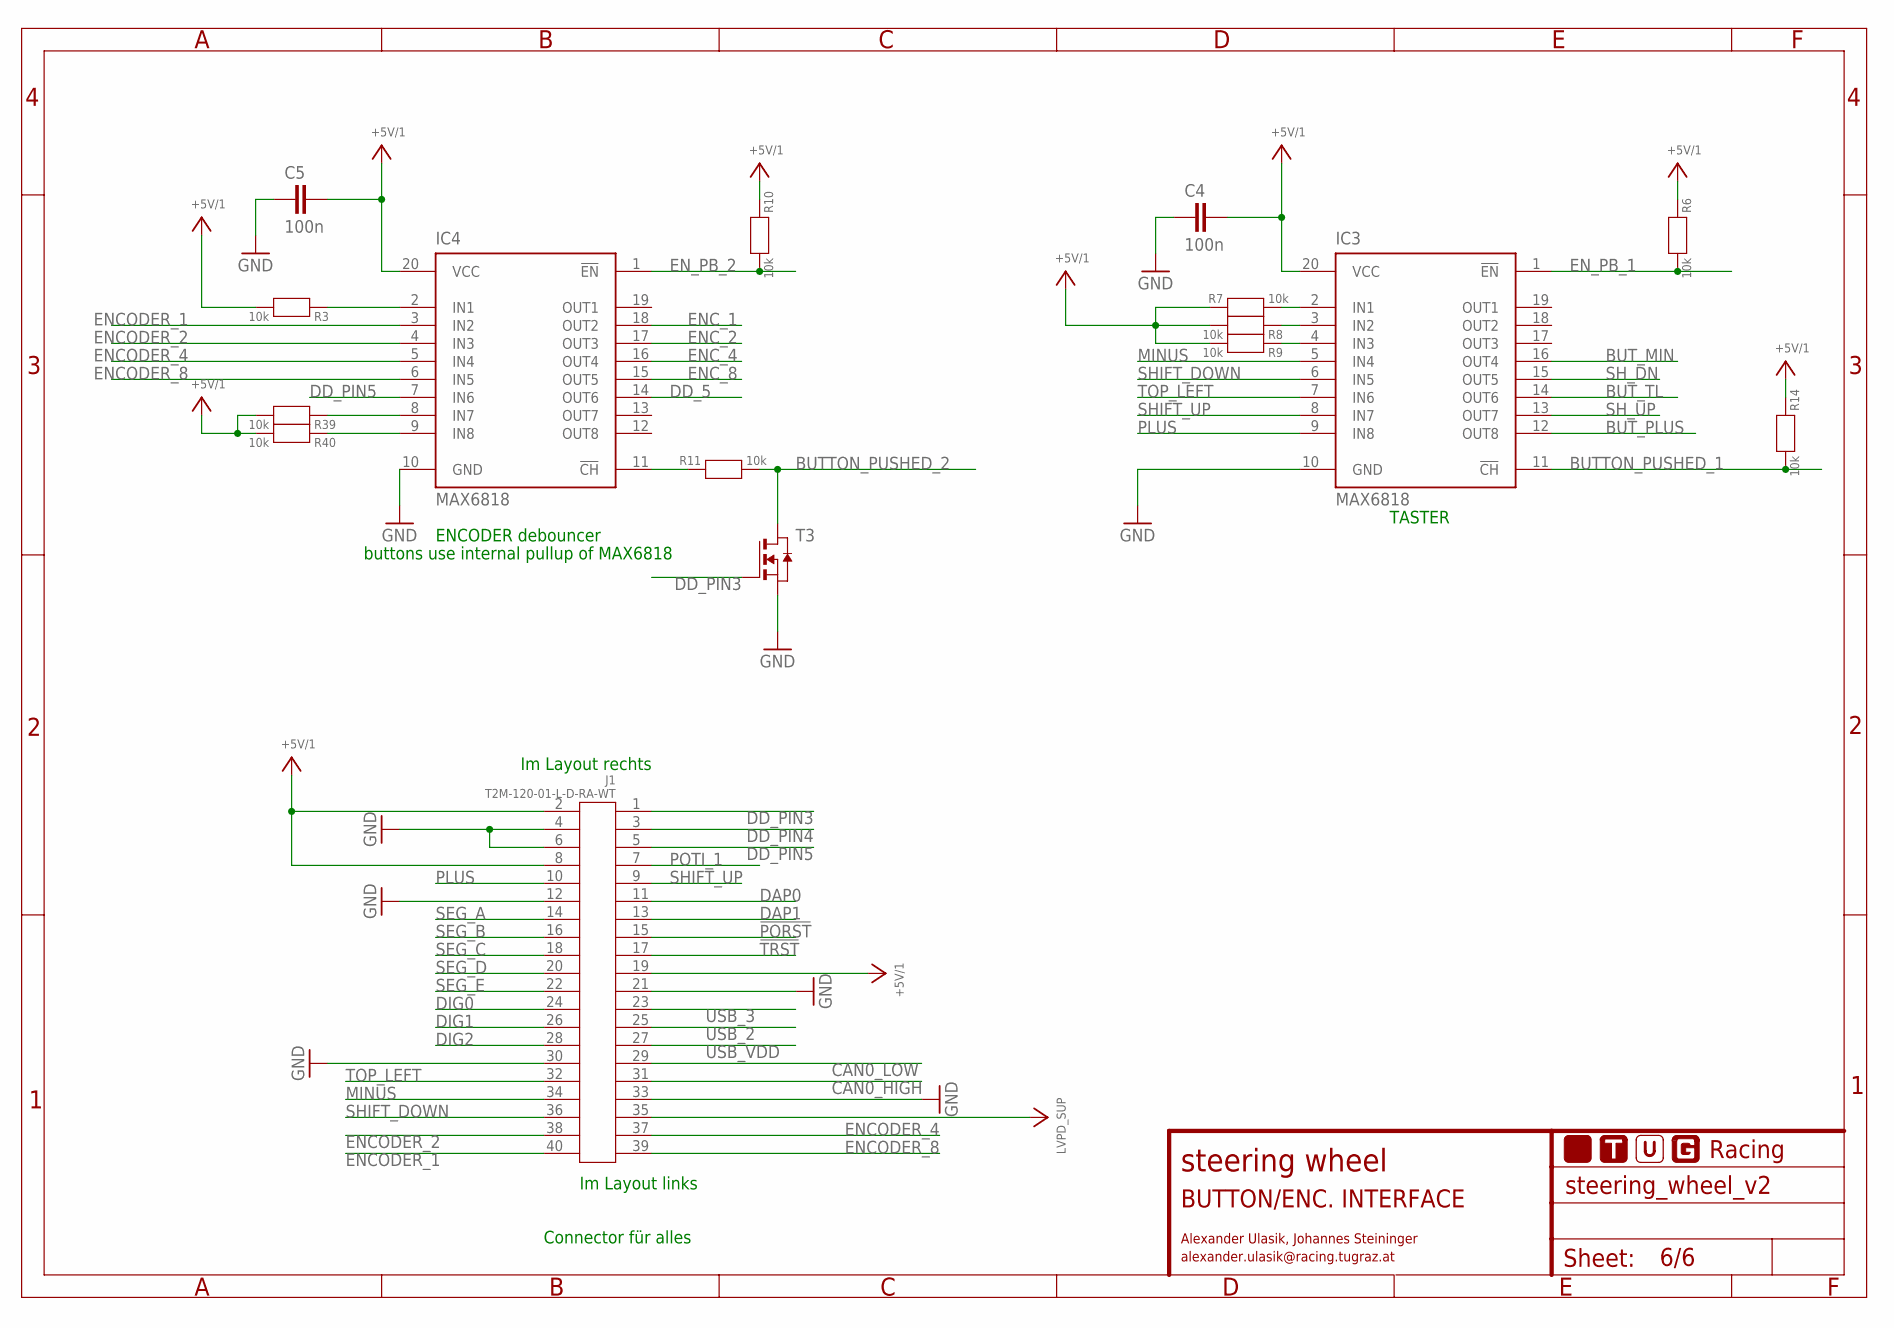
[picture p15: schematic steering_wheel_V2.sch, sheet 6]

Parts:
C4, C5: 100n; C0805
FRAME2: A4L-LOC-RACING-NOLOGO; NOLOGO
IC3, IC4: MAX6818; SSOP20
J1: T2M-120-01-L-D-RA-WT
R3, R6, R7, R8, R9, R10, R11, R14, R39, R40: 10k; 2012M_0805
T3: NMOSSOT23; SOT-23

Connections:
!PORST: J1.15; also elsewhere on the board
!TRST: J1.17; also elsewhere on the board
+5V/1#: C4.2, C5.2, IC3.20 (VCC), IC4.20 (VCC), J1.2, J1.8, J1.19, R3.2, R6.1, R7.1, R8.2, R9.2, R10.1, R14.1, R39.2, R40.2; also elsewhere on the board
BUTTON_PUSHED_1: IC3.11 (!CH), R14.2; also elsewhere on the board
BUTTON_PUSHED_2: R11.2, T3.1 (D); also elsewhere on the board
BUT_MIN: IC3.16 (OUT4); also elsewhere on the board
BUT_PLUS: IC3.12 (OUT8); also elsewhere on the board
BUT_TL: IC3.14 (OUT6); also elsewhere on the board
CAN0_HIGH: J1.31; also elsewhere on the board
CAN0_LOW: J1.29; also elsewhere on the board
DAP0: J1.11; also elsewhere on the board
DAP1: J1.13; also elsewhere on the board
DD_5: IC4.14 (OUT6); also elsewhere on the board
DD_PIN3: J1.1, T3.3 (G); also elsewhere on the board
DD_PIN4: J1.3; also elsewhere on the board
DD_PIN5: IC4.7 (IN6), J1.5
DIG0: J1.24; also elsewhere on the board
DIG1: J1.26; also elsewhere on the board
DIG2: J1.28; also elsewhere on the board
ENCODER_1: IC4.3 (IN2), J1.40
ENCODER_2: IC4.4 (IN3), J1.38
ENCODER_4: IC4.5 (IN4), J1.37
ENCODER_8: IC4.6 (IN5), J1.39
ENC_1: IC4.18 (OUT2); also elsewhere on the board
ENC_2: IC4.17 (OUT3); also elsewhere on the board
ENC_4: IC4.16 (OUT4); also elsewhere on the board
ENC_8: IC4.15 (OUT5); also elsewhere on the board
EN_PB_1: IC3.1 (!EN), R6.2; also elsewhere on the board
EN_PB_2: IC4.1 (!EN), R10.2; also elsewhere on the board
GND: C4.1, C5.1, IC3.10 (GND), IC4.10 (GND), J1.4, J1.6, J1.12, J1.21, J1.30, J1.33, T3.2 (S); also elsewhere on the board
LVPD_SUP: J1.35; also elsewhere on the board
MINUS: IC3.5 (IN4), J1.34
unnamed: IC4.8 (IN7), R39.1
unnamed: IC4.2 (IN1), R3.1
unnamed: IC4.9 (IN8), R40.1
unnamed: IC3.2 (IN1), R7.2
unnamed: IC4.11 (!CH), R11.1
unnamed: IC3.3 (IN2), R8.1
unnamed: IC3.4 (IN3), R9.1
PLUS: IC3.9 (IN8), J1.10
POTI_1: J1.7; also elsewhere on the board
SEG_A: J1.14; also elsewhere on the board
SEG_B: J1.16; also elsewhere on the board
SEG_C: J1.18; also elsewhere on the board
SEG_D: J1.20; also elsewhere on the board
SEG_E: J1.22; also elsewhere on the board
SHIFT_DOWN: IC3.6 (IN5), J1.36
SHIFT_UP: IC3.8 (IN7), J1.9
SH_DN: IC3.15 (OUT5); also elsewhere on the board
SH_UP: IC3.13 (OUT7); also elsewhere on the board
TOP_LEFT: IC3.7 (IN6), J1.32
USB_2: J1.25; also elsewhere on the board
USB_3: J1.23; also elsewhere on the board
USB_VDD: J1.27; also elsewhere on the board

Notes on the sheet:
TASTER
ENCODER debouncer
buttons use internal pullup of MAX6818
Im Layout links
Im Layout rechts
Connector für alles

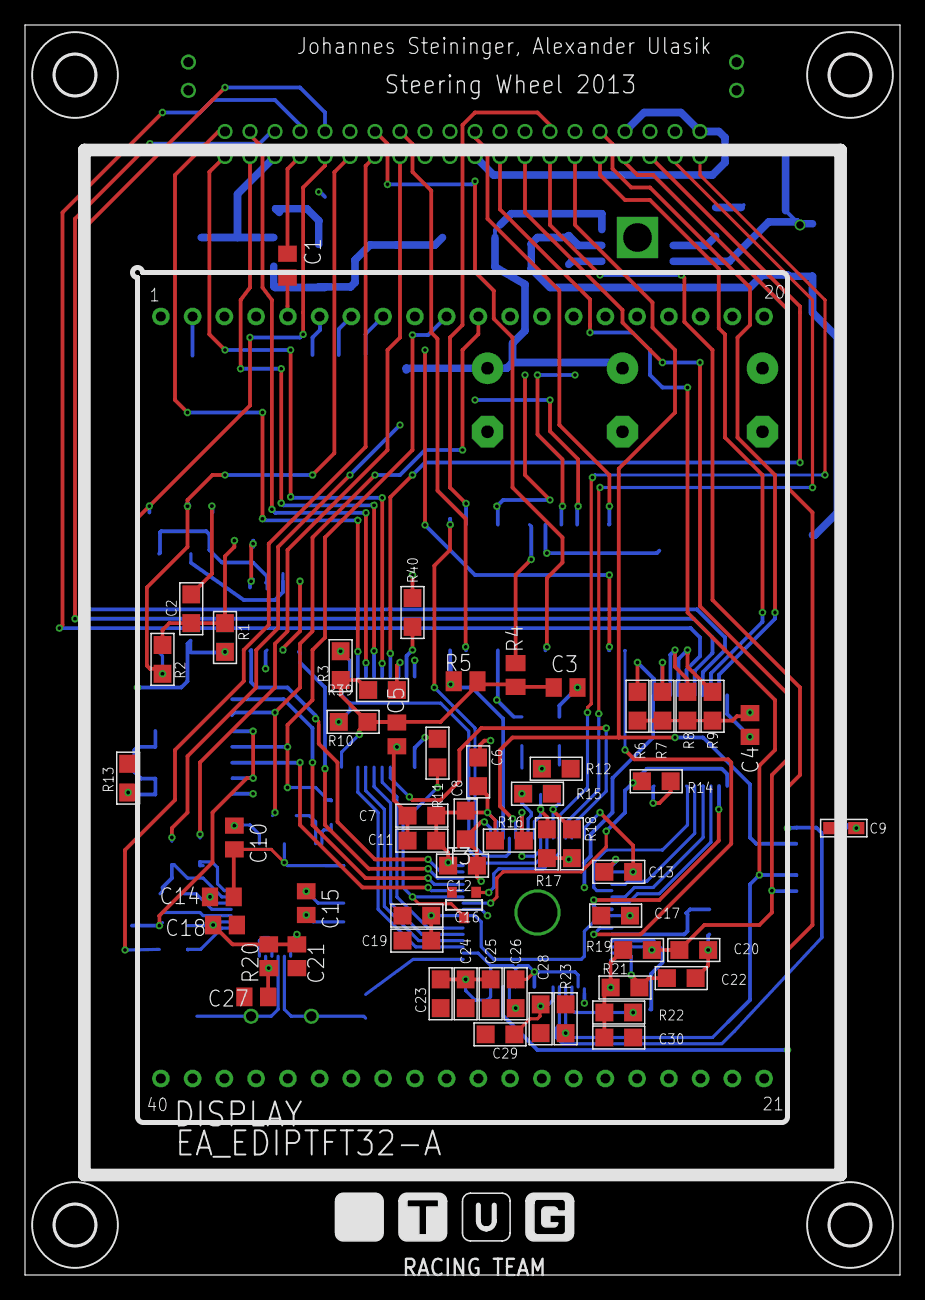
[picture p16: board steering_wheel_V2.brd from above]

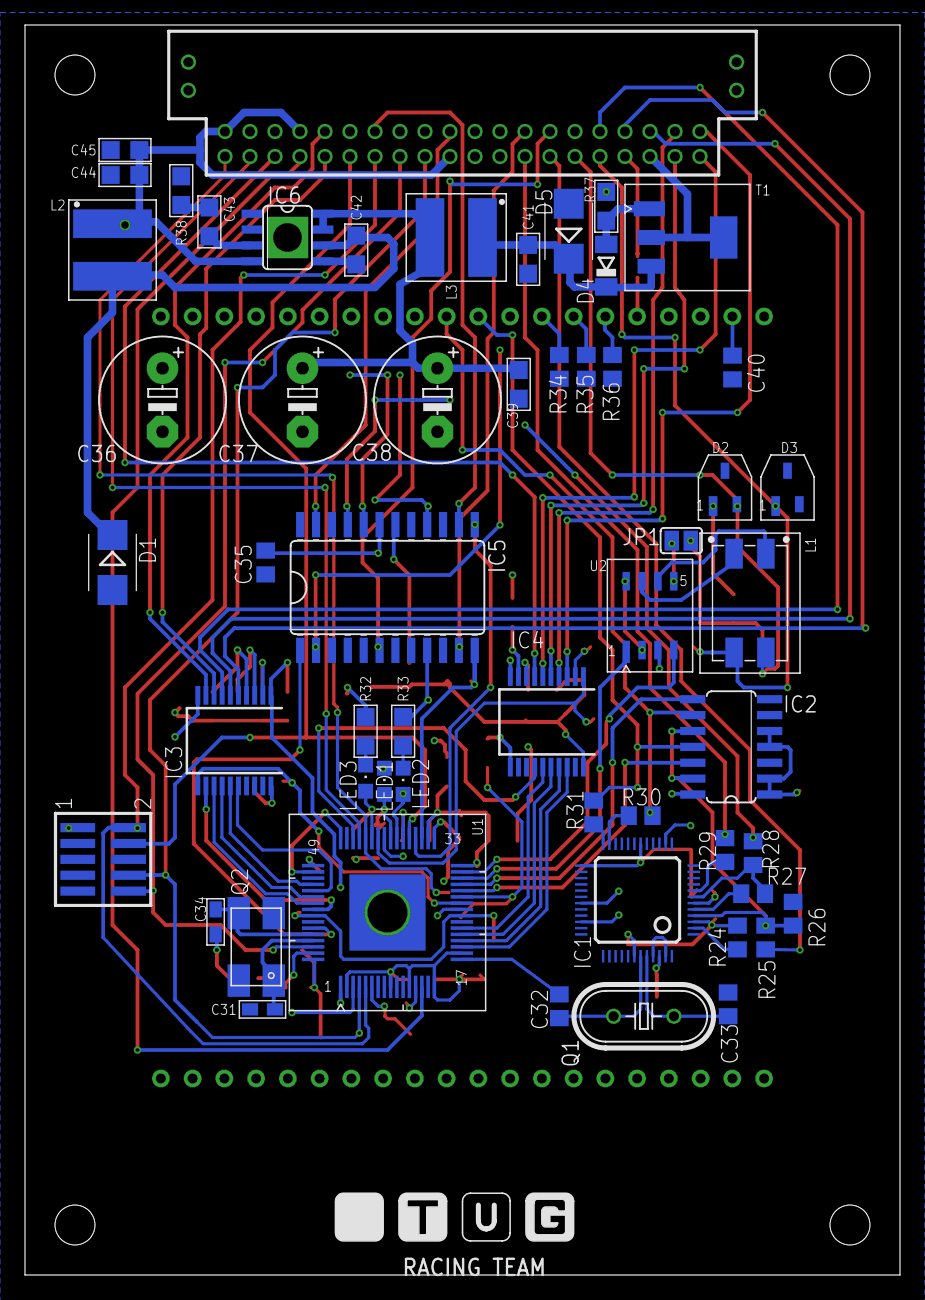
[picture p17: board steering_wheel_V2.brd from below]

Board: 4 copper layers, 70.0 x 100.0 mm, 122 parts (56 on the bottom side), 103 nets.
