fermentedfly/tankia_2013/firmware/applications/SteeringWheelV3/SteeringWheelV3.ioc

Mcu.UserName=STM32F405RGTx
PA10.Signal=USB_OTG_FS_ID
PA11.Signal=USB_OTG_FS_DM
PA12.Signal=USB_OTG_FS_DP
PA13.Signal=SYS_JTMS-SWDIO
PA14.Signal=SYS_JTCK-SWCLK
PA15.GPIO_Label=eDIP_Reset
PA15.Signal=GPIO_Output
PA4.GPIO_Label=ADC1_Clutch
PA4.Signal=ADCx_IN4
PA9.Signal=USB_OTG_FS_VBUS
PB0.GPIO_Label=MAX_Shift_Up
PB0.Signal=GPXTI0
PB1.GPIO_Label=MAX_Plus
PB1.Signal=GPXTI1
PB10.GPIO_Label=nMAX_CH
PB10.Signal=GPXTI10
PB12.GPIO_Label=LED_0
PB12.Signal=GPIO_Output
PB13.GPIO_Label=LED_1
PB13.Signal=GPIO_Output
PB14.GPIO_Label=LED_2
PB14.Signal=GPIO_Output
PB15.GPIO_Label=LED_3
PB15.Signal=GPIO_Output
PB2.GPIO_Label=MAX_Enter
PB2.Signal=GPXTI2
PB3.Signal=SYS_JTDO-SWO
PB6.Signal=I2C1_SCL
PB7.Signal=I2C1_SDA
PB8.Signal=CAN1_RX
PB9.Signal=CAN1_TX
PC0.GPIO_Label=EN_5V
PC0.Signal=GPIO_Output
PC10.Signal=UART4_TX
PC11.Signal=UART4_RX
PC4.GPIO_Label=MAX_SHIFT_DOWN
PC4.Signal=GPXTI4
PC5.GPIO_Label=MAX_MINUS
PC5.Signal=GPXTI5
PH0-OSC_IN.Signal=RCC_OSC_IN
PH1-OSC_OUT.Signal=RCC_OSC_OUT
