fermentedfly/tankia_2013/firmware/applications/SteeringWheelV3/Src/can_messages.c

/*
 * can_messages.c
 *
 *  Created on: Nov 22, 2016
 *      Author: manuel
 */

#include "can_messages.h"
#include "display.h"
#include "drv_can.h"
#include "FreeRTOS.h"
#include "task.h"
#include "queue.h"
#include "event_groups.h"
#include "rpm_leds.h"

static void RxCallback(CanRxMsgTypeDef *rxMsg);

void CAN_MESSAGES_Init(CAN_HandleTypeDef* hcan)
{
  CAN_FilterConfTypeDef can_filter = {
    .FilterNumber = 0,
    .FilterMode = CAN_FILTERMODE_IDMASK,
    .FilterScale = CAN_FILTERSCALE_32BIT,
    .FilterIdHigh = 0x0000,
    .FilterIdLow = 0x0000,
    .FilterMaskIdHigh = 0x0000,
    .FilterMaskIdLow = 0x0000,
    .FilterFIFOAssignment = 0,
    .FilterActivation = ENABLE,
    .BankNumber = 14
  };

  configASSERT(HAL_CAN_ConfigFilter(hcan, &can_filter) == HAL_OK);

  if(hcan->Instance == CAN1)
  {
    configASSERT(CAN_startContinousReceive(hcan, RxCallback) == HAL_OK);
  }
}

void CAN_MESSAGES_TransmitSWShift(CAN_HandleTypeDef* hcan, CAN_MO_SW_Shift_Direction_t direction, uint8_t fromISR)
{
	static CanTxMsgTypeDef msg = {
			.StdId = CAN_MO_ID_SW_SHIFT,
			.IDE = CAN_ID_STD,
			.RTR = CAN_RTR_DATA,
			.DLC = sizeof(CAN_MO_SW_Shift_t),
	};

	((CAN_MO_SW_Shift_t *)msg.Data)->direction = direction;
	CAN_Transmit(hcan, &msg, fromISR);
}

void CAN_MESSAGES_TransmitSWClutch(CAN_HandleTypeDef* hcan, uint8_t value, uint8_t fromISR)
{
	static CanTxMsgTypeDef msg = {
			.StdId = CAN_MO_ID_SW_CLUTCH,
			.IDE = CAN_ID_STD,
			.RTR = CAN_RTR_DATA,
			.DLC = sizeof(CAN_MO_SW_Clutch_t),
	};

	((CAN_MO_SW_Clutch_t *)msg.Data)->value = value;
	CAN_Transmit(hcan, &msg, fromISR);
}

void CAN_MESSAGES_TransmitBCM1(CAN_HandleTypeDef* hcan, uint8_t data_select, uint8_t clutch_points, uint8_t clutch_tolerance, uint16_t c_min, uint16_t c_max, uint8_t fromISR)
{
  static CanTxMsgTypeDef msg = {
      .StdId = CAN_MO_ID_BCM_SETUP_1,
      .IDE = CAN_ID_STD,
      .RTR = CAN_RTR_DATA,
      .DLC = sizeof(CAN_MO_BCM_Setup_1_t),
  };

  ((CAN_MO_BCM_Setup_1_t *)msg.Data)->data_select = data_select;
  ((CAN_MO_BCM_Setup_1_t *)msg.Data)->clutch_points = clutch_points;
  ((CAN_MO_BCM_Setup_1_t *)msg.Data)->clutch_tolerance = clutch_tolerance;
  ((CAN_MO_BCM_Setup_1_t *)msg.Data)->c_sens_min = c_min;
  ((CAN_MO_BCM_Setup_1_t *)msg.Data)->c_sens_max = c_max;

  CAN_Transmit(hcan, &msg, fromISR);
}

static void RxCallback(CanRxMsgTypeDef *rxMsg)
{
  configASSERT(rxMsg->IDE == CAN_ID_STD);

  HAL_GPIO_WritePin(LED_GPIO_Port, LED_0_Pin, GPIO_PIN_RESET);

  switch(rxMsg->StdId)
    {
      case CAN_MO_ID_BCM_SETUP_CONFIRM_1:
      {
        CAN_MO_BCM_Setup_1_t *msg = (CAN_MO_BCM_Setup_1_t *)rxMsg->Data;
        DISPLAY_DATA_ClutchNormal.clutch_points = msg->clutch_points;
        DISPLAY_DATA_ClutchNormal.clutch_tolerance = msg->clutch_tolerance;
        DISPLAY_DATA_ClutchNormal.c_sens_min = msg->c_sens_min;
        DISPLAY_DATA_ClutchNormal.c_sens_max = msg->c_sens_max;

        break;
      }

      case CAN_MO_ID_BCM_SETUP_CONFIRM_2:
      {
        CAN_MO_BCM_Setup_2_t *msg = (CAN_MO_BCM_Setup_2_t *)rxMsg->Data;
        DISPLAY_DATA_GearACC.g_acc_min_speed = msg->g_acc_min_speed;
        DISPLAY_DATA_GearACC.g_acc_max_wspin = msg->g_acc_max_wspin;
        DISPLAY_DATA_GearACC.g_acc_shift_rpm_1 = msg->g_acc_shift_rpm_1;
        DISPLAY_DATA_GearACC.g_acc_shift_rpm_2 = msg->g_acc_shift_rpm_2;
        DISPLAY_DATA_GearACC.g_acc_shift_rpm_3 = msg->g_acc_shift_rpm_3;

        break;
      }

      case CAN_MO_ID_BCM_SETUP_CONFIRM_3:
      {
        CAN_MO_BCM_Setup_3_t *msg = (CAN_MO_BCM_Setup_3_t *)rxMsg->Data;
        DISPLAY_DATA_GearControl.g_min_shift_delay = msg->g_min_shift_delay;
        DISPLAY_DATA_GearControl.g_up_holdtime = msg->g_up_holdtime;
        DISPLAY_DATA_GearControl.g_dn_holdtime = msg->g_dn_holdtime;
        DISPLAY_DATA_GearControl.g_n_holdtime = msg->g_n_holdtime;
        DISPLAY_DATA_Racepage.map = msg->map;
        DISPLAY_DATA_Racepage.traction = msg->traction;

        break;
      }

      case CAN_MO_ID_BCM_SETUP_CONFIRM_4:
      {
        CAN_MO_BCM_Setup_4_t *msg = (CAN_MO_BCM_Setup_4_t *)rxMsg->Data;
        DISPLAY_DATA_ClutchACC.acc_clutch_p1 = msg->acc_clutch_p1;
        DISPLAY_DATA_ClutchACC.acc_clutch_p2 = msg->acc_clutch_p2;
        DISPLAY_DATA_ClutchACC.acc_clutch_k1 = msg->acc_clutch_k1;
        DISPLAY_DATA_ClutchACC.acc_clutch_k2 = msg->acc_clutch_k2;
        DISPLAY_DATA_ClutchACC.acc_clutch_k3 = msg->acc_clutch_k3;

        break;
      }

      case CAN_MO_ID_LVPD_SETUP_CONFIRM_1:
      {
        CAN_MO_LVPD_Setup_1_t *msg = (CAN_MO_LVPD_Setup_1_t *)rxMsg->Data;
        DISPLAY_DATA_PowerFan.fan_off_temp = msg->fan_off_temp;
        DISPLAY_DATA_PowerFan.fan_on_temp = msg->fan_on_temp;
        DISPLAY_DATA_PowerFan.fan_off_rpm = msg->fan_off_rpm;
        DISPLAY_DATA_PowerFan.fan_on_rpm = msg->fan_on_rpm;

        break;
      }
      case CAN_MO_ID_LVPD_SETUP_CONFIRM_2:
       {
         CAN_MO_LVPD_Setup_2_t *msg = (CAN_MO_LVPD_Setup_2_t *)rxMsg->Data;
         DISPLAY_DATA_PowerCurrent.enable_bitfield = msg->enable_bitfield;
         DISPLAY_DATA_PowerCurrent.threshold_value[msg->threshold_multiplex] = msg->threshold_value;

         break;
       }

      case CAN_MO_ID_MS4_IRA:
      {
        CAN_MO_MS4_IRA_t *msg = (CAN_MO_MS4_IRA_t *)rxMsg->Data;
        DISPLAY_DATA_Racepage.rev = ((((uint32_t)msg->rev_msb) << 8) + msg->rev_lsb) * 0.5;
        DISPLAY_DATA_Racepage.ath = msg->ath * 100 / 256;

        RPM_LEDS_rev = (msg->rev_msb << 16) + msg->rev_lsb;

        break;
      }

      case CAN_MO_ID_MS4_SPEED:
      {
        CAN_MO_MS4_Speed_t *msg = (CAN_MO_MS4_Speed_t *)rxMsg->Data;
        DISPLAY_DATA_Racepage.speed = ((((uint32_t)msg->speed_msb) << 8) + msg->speed_lsb) * 512 / 65536;

        break;
      }

      case CAN_MO_ID_MS4_GDA:
      {
        CAN_MO_MS4_GDA_t *msg = (CAN_MO_MS4_GDA_t *)rxMsg->Data;
        DISPLAY_DATA_Racepage.gear = msg->gear;

        break;
      }

      case CAN_MO_ID_MS4_SBDB:
      {
        CAN_MO_MS4_SBDB_t *msg = (CAN_MO_MS4_SBDB_t *)rxMsg->Data;

        if(msg->row_counter == 4)
          DISPLAY_DATA_Racepage.toil = msg->muxed.row_4.toil - 40;
        if(msg->row_counter == 5)
          DISPLAY_DATA_Racepage.twat = msg->muxed.row_5.tmot - 40;

        break;
      }
    };

  HAL_GPIO_WritePin(LED_GPIO_Port, LED_0_Pin, GPIO_PIN_SET);
}
