fermentedfly/tankia_2013/firmware/Driver/Inc/drv_adc.h

#ifndef __adc_H
#define __adc_H

#include "stm32f4xx_hal.h"
#include "FreeRTOS.h"

#ifdef HAL_ADC_MODULE_ENABLED

HAL_StatusTypeDef  ADC_Init(ADC_HandleTypeDef *handle);
HAL_StatusTypeDef ADC_StartSingleConversion(ADC_HandleTypeDef *handle);
HAL_StatusTypeDef ADC_StartContinousConversion(ADC_HandleTypeDef *handle, TickType_t period);

#endif
#endif /*__ adc_H */
