fermentedfly/tankia_2013/(commit log)

2016-08-13 boneX microscope light strip
    [boneX_led_strip.brd, boneX_led_strip.sch]
2016-08-13 thermocouple max31855 board
    [thermocouple_v0.1.brd, thermocouple_v0.1.sch]
2016-08-20 added buck converter for laser board (layout designed to contact to Li-Ion 18650 Cylindrical)
    [laser_buck_converter.brd, laser_buck_converter.sch]
2016-09-01 fixed eagle errors due to upgrade to 6.5
    [thermocouple_v0.1.brd, thermocouple_v0.1.sch]
2016-09-13 added tankia 2013 steering wheel v3
    [flackerlicht.brd, flackerlicht.sch, led_mask.brd, led_mask.sch, steering_wheel_V2.brd, steering_wheel_V2.sch, steering_wheel_V3.brd, steering_wheel_V3.sch]
2016-10-11 added todo for steering wheel 2013
2016-11-08 added basic project for steering wheel
2016-11-13 fixed broken scheduler start
    [display.c, main.c]
2016-11-22 can driver split between application and driver
2016-11-22 added usb driver
2016-11-23 another round of restructureing + MAX7313 driver
    [steering_wheel_V3.0.brd, steering_wheel_V3.0.sch]
2016-11-23 added v3.1 layout with bugfixes (i2c pullup, led resistors)
    [steering_wheel_V3.1.brd, steering_wheel_V3.1.sch]
2016-11-25 added adc for clutch conversion and basic processing
2017-01-08 added stm32f7 breakout board
    [steering_wheel_V3.1.brd, steering_wheel_V3.1.sch, stm32f76XV_breakout.brd, stm32f76XV_breakout.sch]
2017-01-08 added samtec jtag debug connector
2017-01-09 aligned all pinheaders to 2.54mm
    [stm32f76XV_breakout.brd]
2017-02-13 added complete hal drivers, added superled driver project
2017-02-13 some further work at steering wheel
2017-02-13 added triac driver board
    [230V_AC_Switch.brd, 230V_AC_Switch.sch, stm32f76XV_breakout.brd, stm32f76XV_breakout.sch]
2017-03-25 updated layout, changed old 20 pin IDC to new 10 pin debug
    [steering_wheel_V3.1.brd, steering_wheel_V3.1.sch]
2017-08-12 fixed wrong ifdefs in drv_usart, removed program mode macro
    [drv_usart.c, drv_usart.h, main.c]
2017-08-12 can send working, problems with receive
    [can_messages.c, can_messages.h, display.c, display.h, main.c]
2017-08-20 can now functional, added update bargraph to display driver
2017-09-18 buttons + / shift up / enter ok, left side buttons not working, leds not working
    [dev_max7313.c, dev_max7313.h, display.c, main.c]
2017-10-05 added scaling for clutch adc
2017-10-05 added oil and water temperature to racepage
2017-10-05 fixed bad can IDs of clutch and switch, fixed clutch reversed, disabled LEDS
    [can_messages.h, main.c]
2017-10-14 added MS4 function sheet, fixed speed calcuation
    [can_messages.c, display.c]
2017-10-24 added breakout for TPS22810
    [TPS22810_breakout.brd, TPS22810_breakout.sch]
2018-11-23 change repo to contain only tankia stuff
    [230V_AC_Switch.brd, 230V_AC_Switch.sch, TPS22810_breakout.brd, TPS22810_breakout.sch, boneX_led_strip.brd, boneX_led_strip.sch, flackerlicht.brd, flackerlicht.sch]
