fermentedfly/tankia_2013/(notices)

Notices in the files:
firmware/applications/SteeringWheelV3/Inc/main.h:
Copyright (c) 2016 STMicroelectronics International N.V.
All rights reserved.
(C) COPYRIGHT STMicroelectronics *****END OF FILE
